eelstretching/led-processor-board/docs/pcb-3d-bottom.png

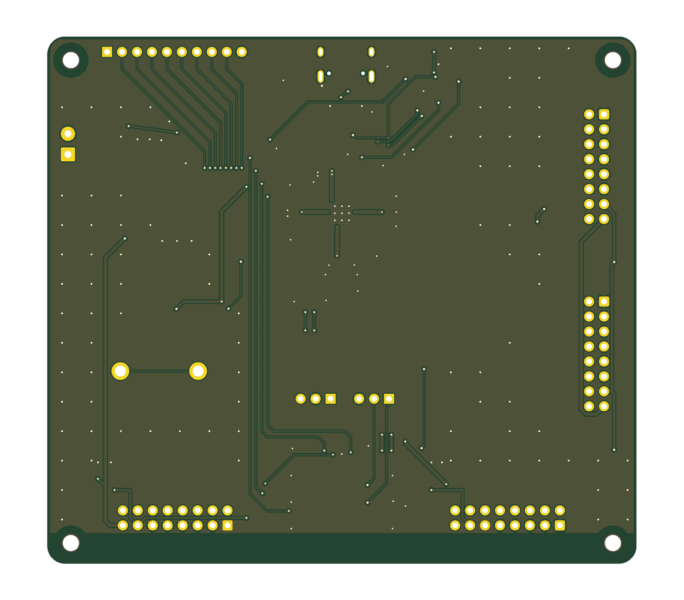
docs/pcb-3d-bottom.png
