eelstretching/led-processor-board/docs/pcb-3d-top.png

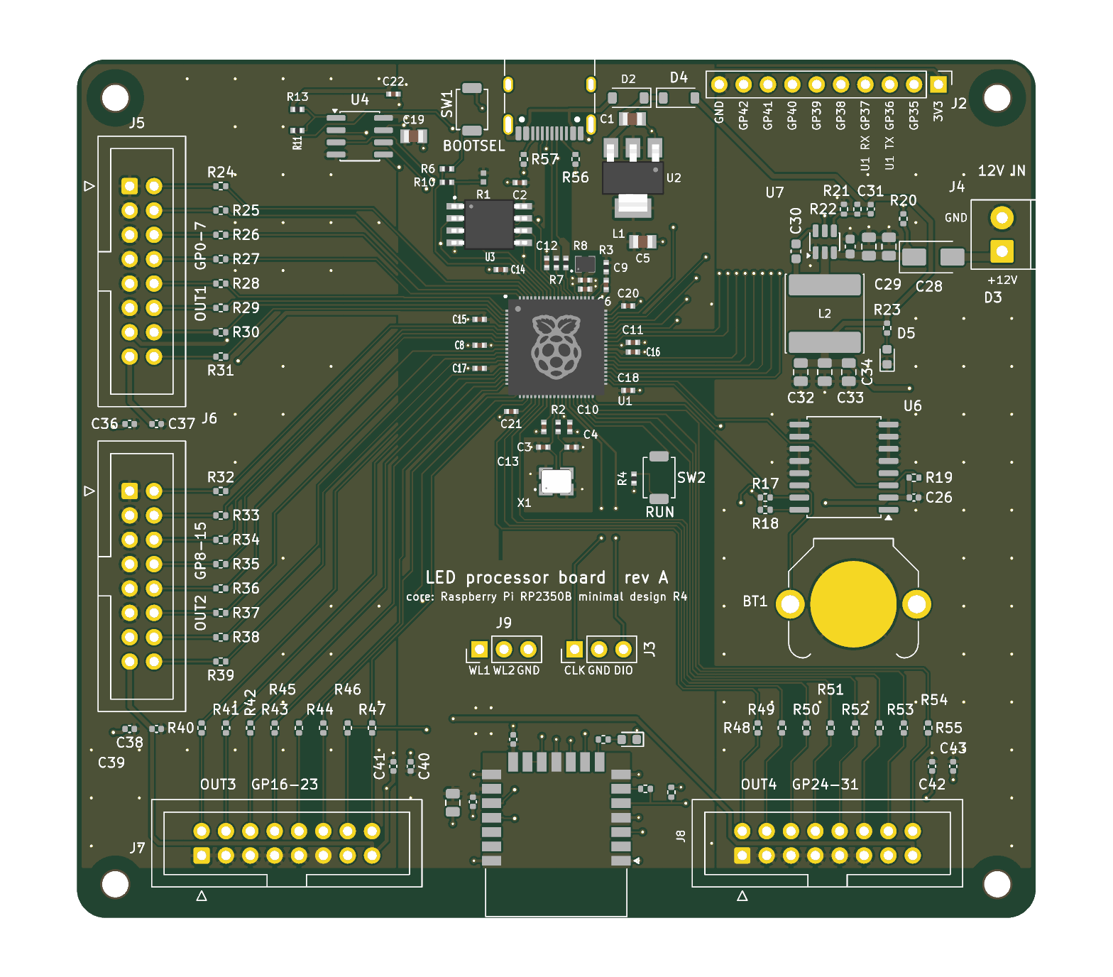
docs/pcb-3d-top.png
