eelstretching/led-processor-board/docs/pcb-bottom-copper.png

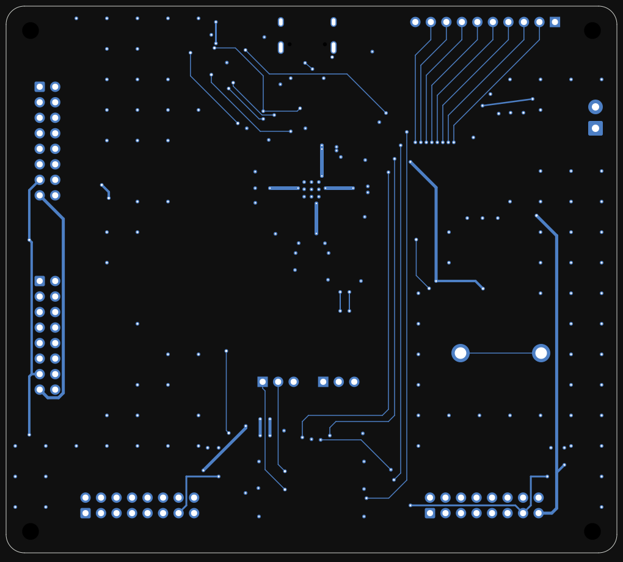
docs/pcb-bottom-copper.png
