eelstretching/led-processor-board/docs/sheet-outputs.png

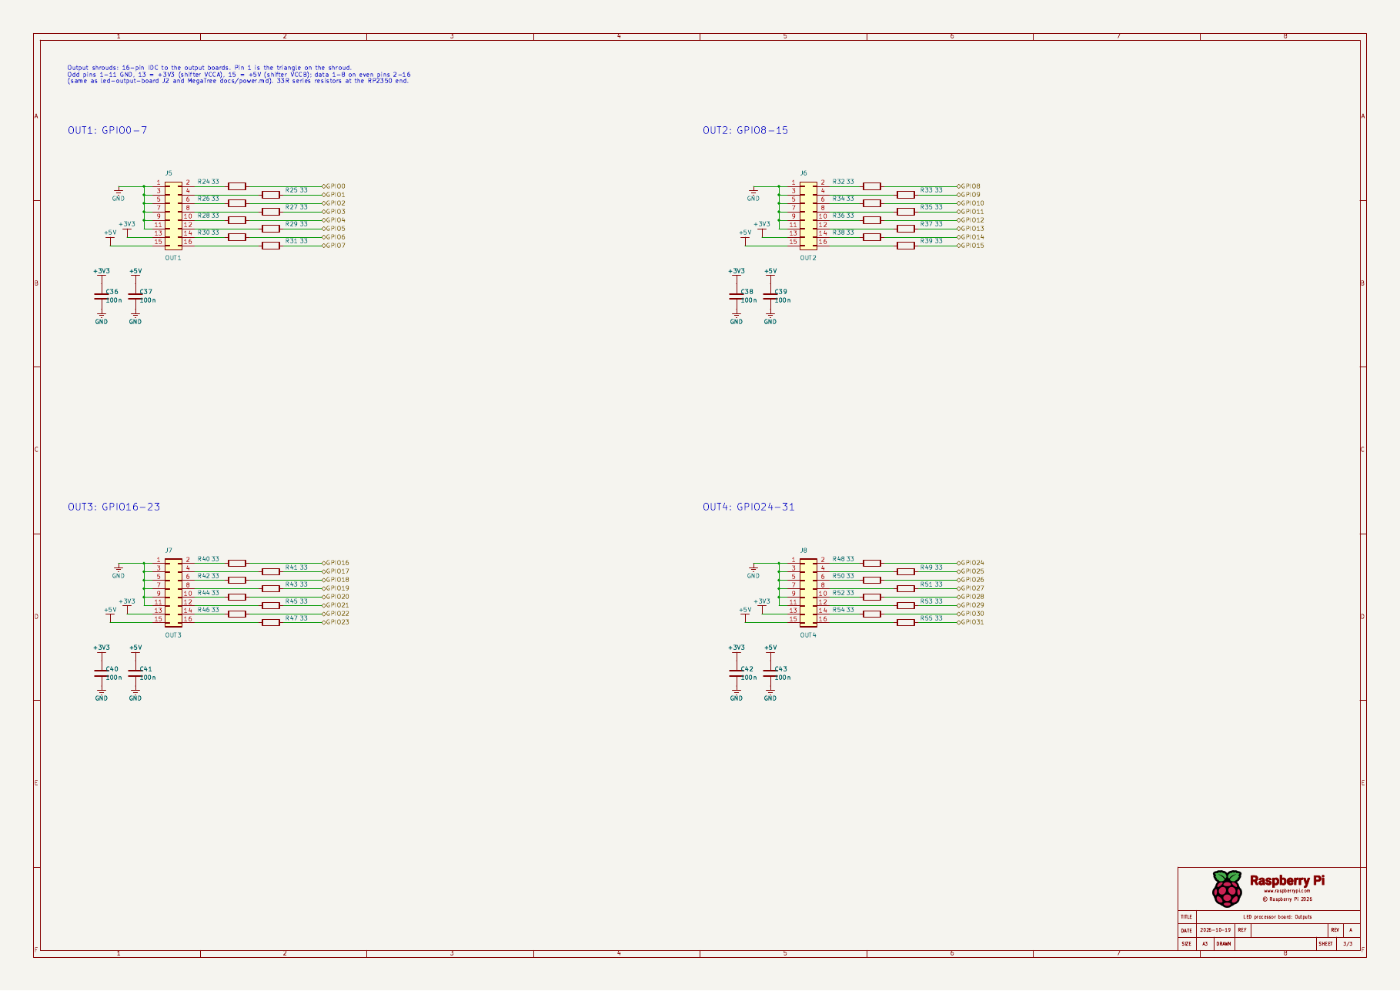
docs/sheet-outputs.png
