eelstretching/led-processor-board/docs/sheet-power.png

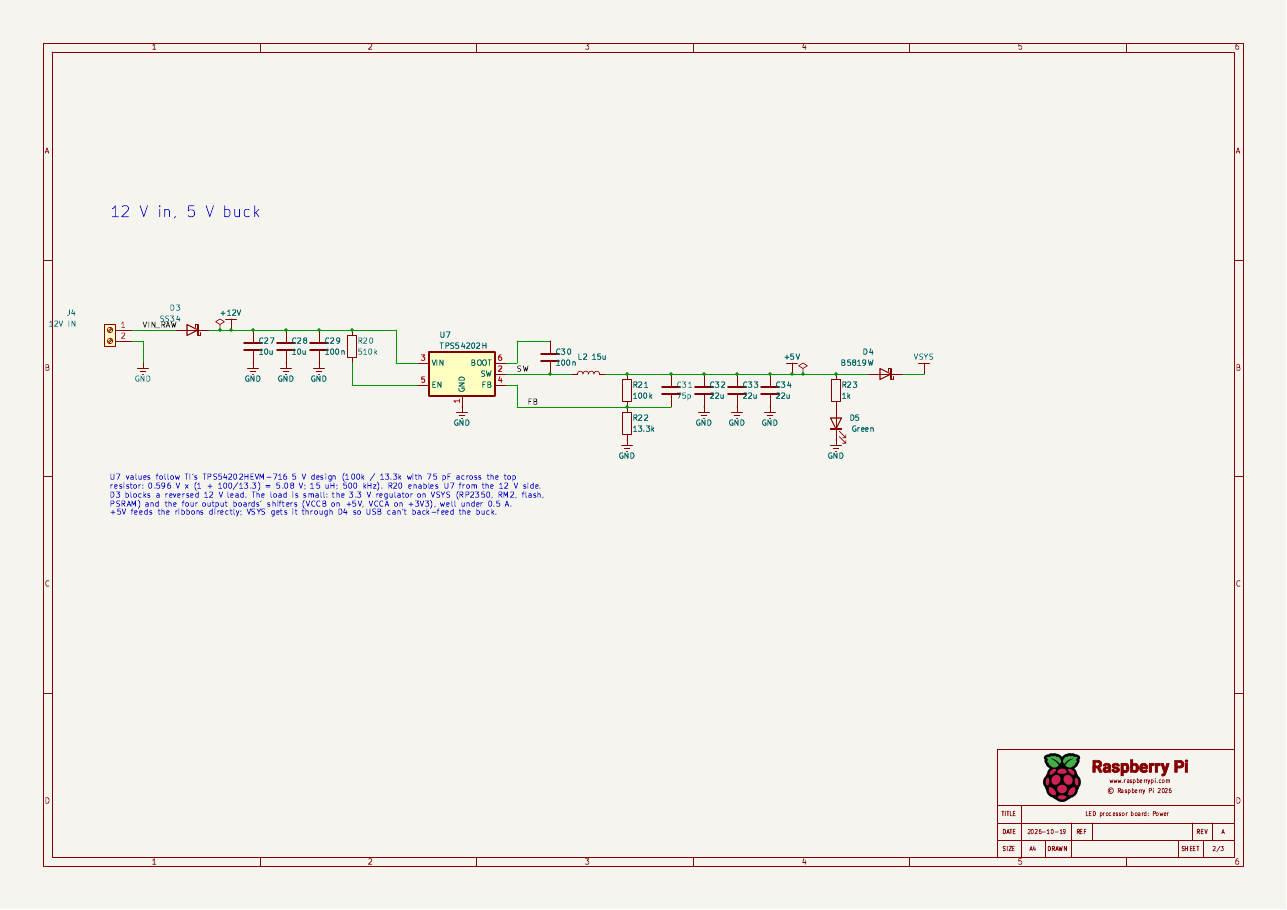
docs/sheet-power.png
