eelstretching/led-processor-board/docs/silk-v1.1/after-full.png

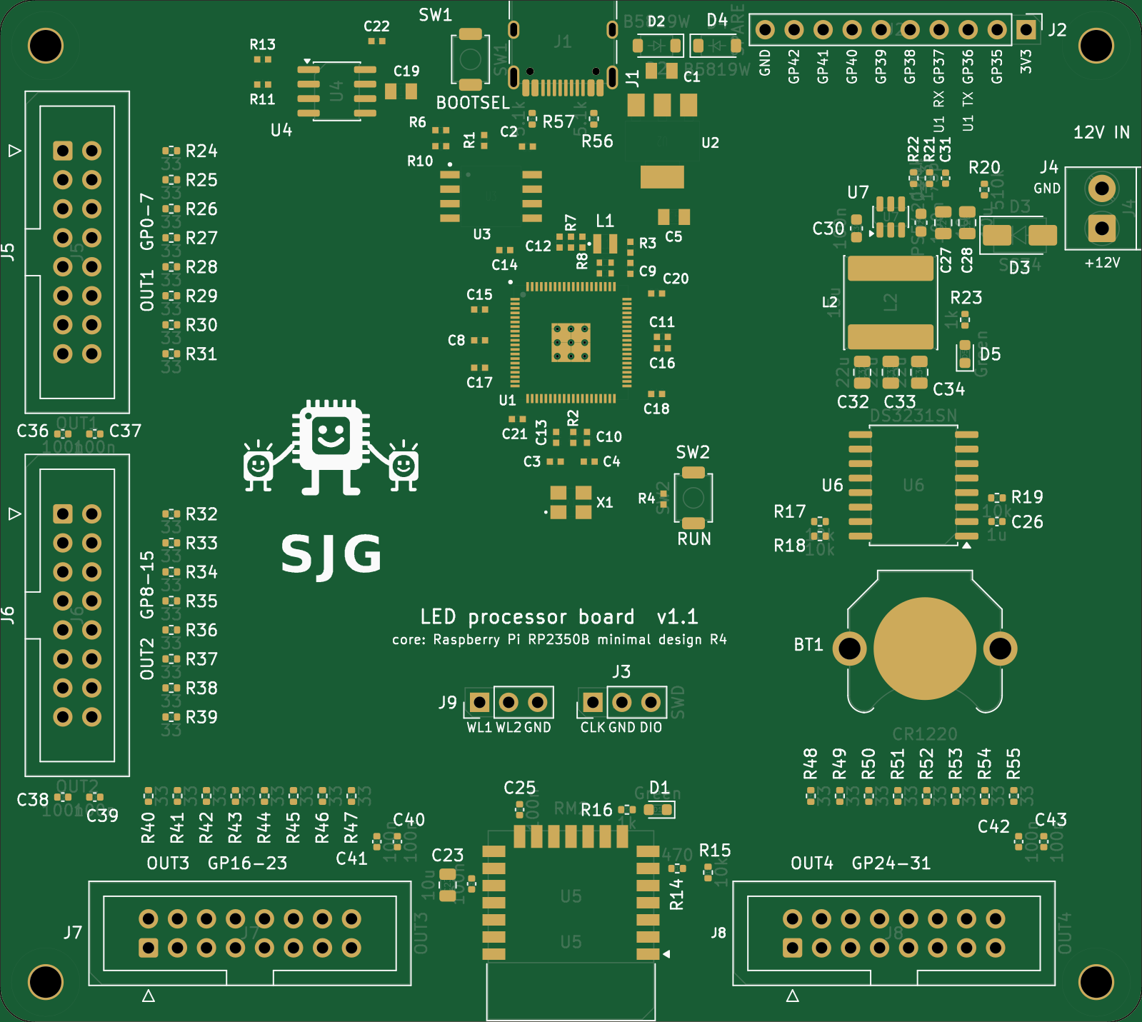
docs/silk-v1.1/after-full.png
