eelstretching/led-processor-board/docs/silk-v1.1/before-full.png

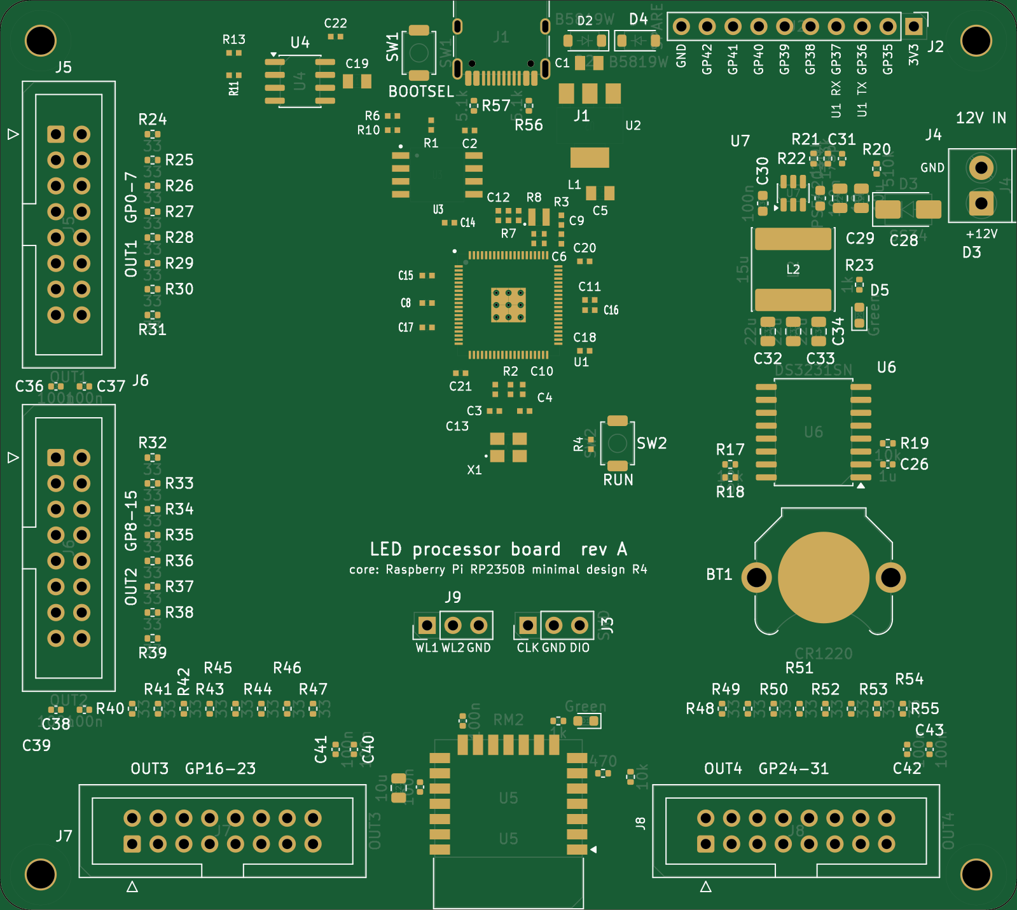
docs/silk-v1.1/before-full.png
