eelstretching/led-processor-board/docs/silk-v1.1/buck-before-after.png

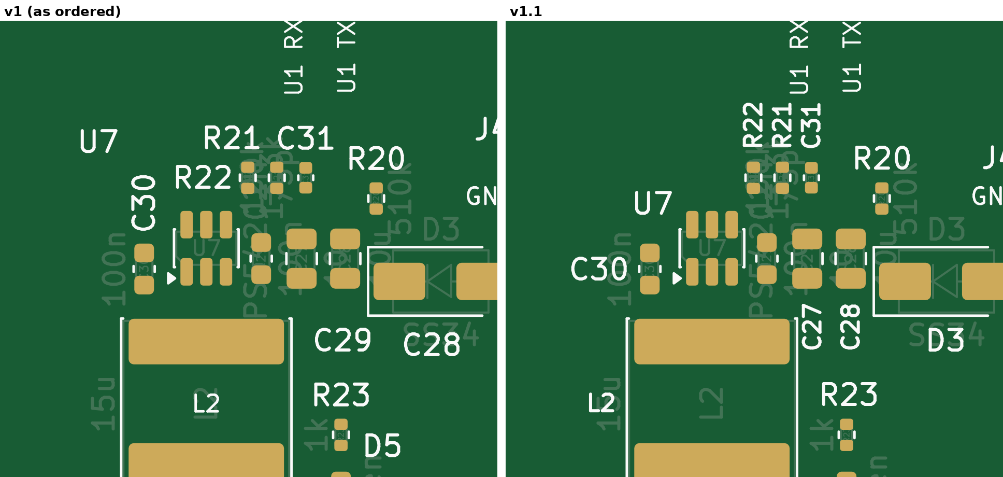
docs/silk-v1.1/buck-before-after.png
