eelstretching/led-processor-board/docs/silk-v1.1/l1-before-after.png

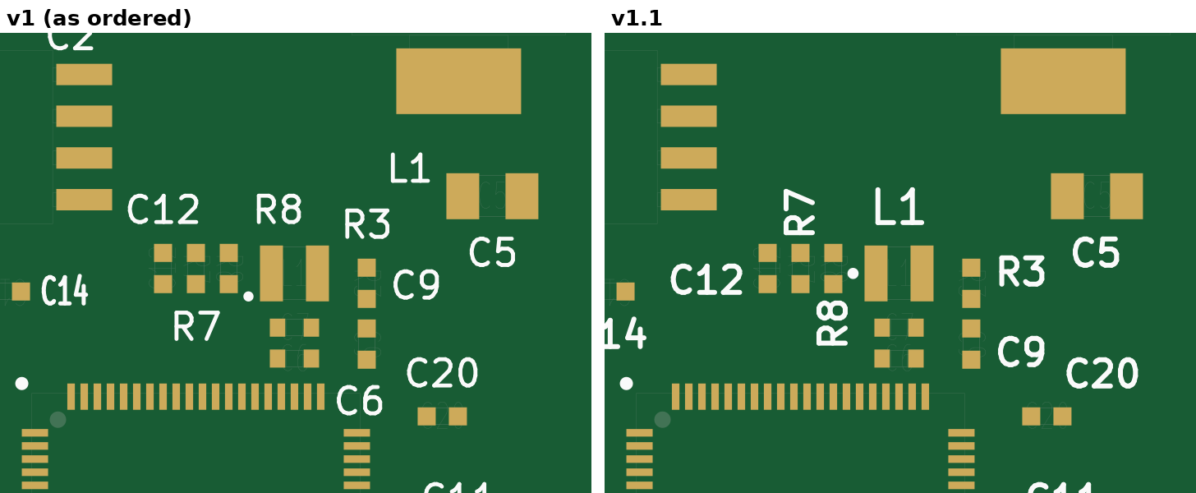
docs/silk-v1.1/l1-before-after.png
