eelstretching/led-processor-board/production/bom-full.csv

Comment | Designator | Footprint | LCSC | Manufacturer PN | Qty | Note
CR1220 | BT1 | BatteryHolder_Keystone_3001_1x12mm |  | 3001 | 1 | Not at LCSC: Keystone 3001 (Digi-Key 36-3001-ND), hand-solder
10u | C1,C5,C19 | generic_capc2012x125 | C15850 | CL21A106KAYNNNE | 3
100n | C2,C8,C10,C11,C12,C13,C14,C15,C16,C17,C18,C20,C21,C22 | generic_capc1005x50 | C1525 | CL05B104KO5NNNC | 14
15p | C3,C4 | generic_capc1005x50 | C1548 | 0402CG150J500NT | 2
4.7u | C6,C7 | generic_capc1005x50_wide | C23733 | CL05A475MP5NRNC | 2
4.7u | C9 | generic_capc1005x50 | C23733 | CL05A475MP5NRNC | 1
10u | C23 | C_0805_2012Metric | C15850 | CL21A106KAYNNNE | 1
100n | C24,C25,C36,C37,C38,C39,C40,C41,C42,C43 | C_0402_1005Metric | C1525 | CL05B104KO5NNNC | 10
1u | C26 | C_0402_1005Metric | C52923 | CL05A105KA5NQNC | 1
10u | C27,C28 | C_0805_2012Metric | C440198 | CL21A106KBYNNNE | 2
100n | C29,C30 | C_0603_1608Metric | C14663 | CC0603KRX7R9BB104 | 2
75p | C31 | C_0402_1005Metric | C37809 | 0402CG750J500NT | 1
22u | C32,C33,C34 | C_0805_2012Metric | C45783 | CL21A226MAQNNNE | 3
Green | D1,D5 | LED_0603_1608Metric | C2289 | KT-0603YG | 2
B5819W | D2,D4 | D_SOD-123 | C8598 | B5819W SL | 2
SS34 | D3 | D_SMA | C8678 | SS34 | 1
USB-C | J1 | USB_C_Receptacle_HRO_TYPE-C-31-M-12 | C165948 | TYPE-C-31-M-12 | 1
SPARE | J2 | PinHeader_1x10_P2.54mm_Vertical |  | 1x10 2.54 mm pin header | 1 | Through-hole: hand-solder
SWD | J3 | PinHeader_1x03_P2.54mm_Vertical |  | 1x3 2.54 mm pin header | 1 | Through-hole: hand-solder
12V IN | J4 | TerminalBlock_Phoenix_PT-1,5-2-3.5-H_1x02_P3.50mm_Horizontal | C695629 | DB301V-3.5-2P-GN-S | 1 | Through-hole
OUT1 | J5 | IDC-Header_2x08_P2.54mm_Vertical |  | Box header 2x08 2.54 mm | 1 | Through-hole: hand-solder (same shroud as the output boards)
OUT2 | J6 | IDC-Header_2x08_P2.54mm_Vertical |  | Box header 2x08 2.54 mm | 1 | Through-hole: hand-solder (same shroud as the output boards)
OUT3 | J7 | IDC-Header_2x08_P2.54mm_Vertical |  | Box header 2x08 2.54 mm | 1 | Through-hole: hand-solder (same shroud as the output boards)
OUT4 | J8 | IDC-Header_2x08_P2.54mm_Vertical |  | Box header 2x08 2.54 mm | 1 | Through-hole: hand-solder (same shroud as the output boards)
WL_GPIO | J9 | PinHeader_1x03_P2.54mm_Vertical |  | 1x3 2.54 mm pin header | 1 | Through-hole: hand-solder
3.3u | L1 | abracon_aota-b201610s3r3-101-t | C42411119 | AOTA-B201610S3R3-101-T | 1
15u | L2 | L_Sunlord_SWPA8040S | C16853 | SWPA8040S150MT | 1
1k | R2,R4,R6 | generic_resc1005x35 | C11702 | 0402WGF1001TCE | 3
33 | R3 | generic_resc1005x35 | C25105 | 0402WGF330JTCE | 1
27 | R7,R8 | generic_resc1005x35 | C25100 | 0402WGF270JTCE | 2
0 | R10,R11 | generic_resc1005x35 | C17168 | 0402WGF0000TCE | 2
10k | R13 | generic_resc1005x35 | C25744 | 0402WGF1002TCE | 1
470 | R14 | R_0402_1005Metric | C25117 | 0402WGF4700TCE | 1
10k | R15,R17,R18,R19 | R_0402_1005Metric | C25744 | 0402WGF1002TCE | 4
1k | R16,R23 | R_0402_1005Metric | C11702 | 0402WGF1001TCE | 2
510k | R20 | R_0402_1005Metric | C11616 | 0402WGF5103TCE | 1
100k | R21 | R_0402_1005Metric | C25741 | 0402WGF1003TCE | 1
13.3k | R22 | R_0402_1005Metric | C122547 | 0402WGF1332TCE | 1
33 | R24,R25,R26,R27,R28,R29,R30,R31,R32,R33,R34,R35,R36,R37,R38,R39,R40,R41,R42,R43,R44,R45,R46,R47,R48,R49,R50,R51,R52,R53,R54,R55 | R_0402_1005Metric | C25105 | 0402WGF330JTCE | 32
5.1k | R56,R57 | R_0402_1005Metric | C25905 | 0402WGF5101TCE | 2
TS-1088R-02526 | SW1,SW2 | SW_SPST_TS-1088-xR025 | C455281 | TS-1088R-02526 | 2
RP2350B | U1 | rpi_rp2350b_vias | C42415655 | RP2350B | 1
NCP1117ST33T3G | U2 | onsemi_ncp1117st33t3g | C26537 | NCP1117ST33T3G | 1
W25Q128JVSIQ | U3 | generic_soic127p790x195-8 | C97521 | W25Q128JVSIQ | 1
APS6404L-3SQR-SN | U4 | SOIC-8_3.9x4.9mm_P1.27mm | C5333729 | APS6404L-3SQR-SN | 1
RM2 | U5 | RPi_RM2 |  | SC1169 (RMC20452T) | 1 | Not at LCSC: buy RM2 (Raspberry Pi SC1169) and hand-solder
DS3231SN | U6 | SOIC-16W_7.5x10.3mm_P1.27mm | C9866 | DS3231SN#T&R | 1
TPS54202H | U7 | SOT-23-6 | C527684 | TPS54202HDDCR | 1
12MHz | X1 | generic_xtalcc320x250x80-4 | C20625731 | ABM8-272-T3 | 1
