eelstretching/led-processor-board/docs/schematic.pdf

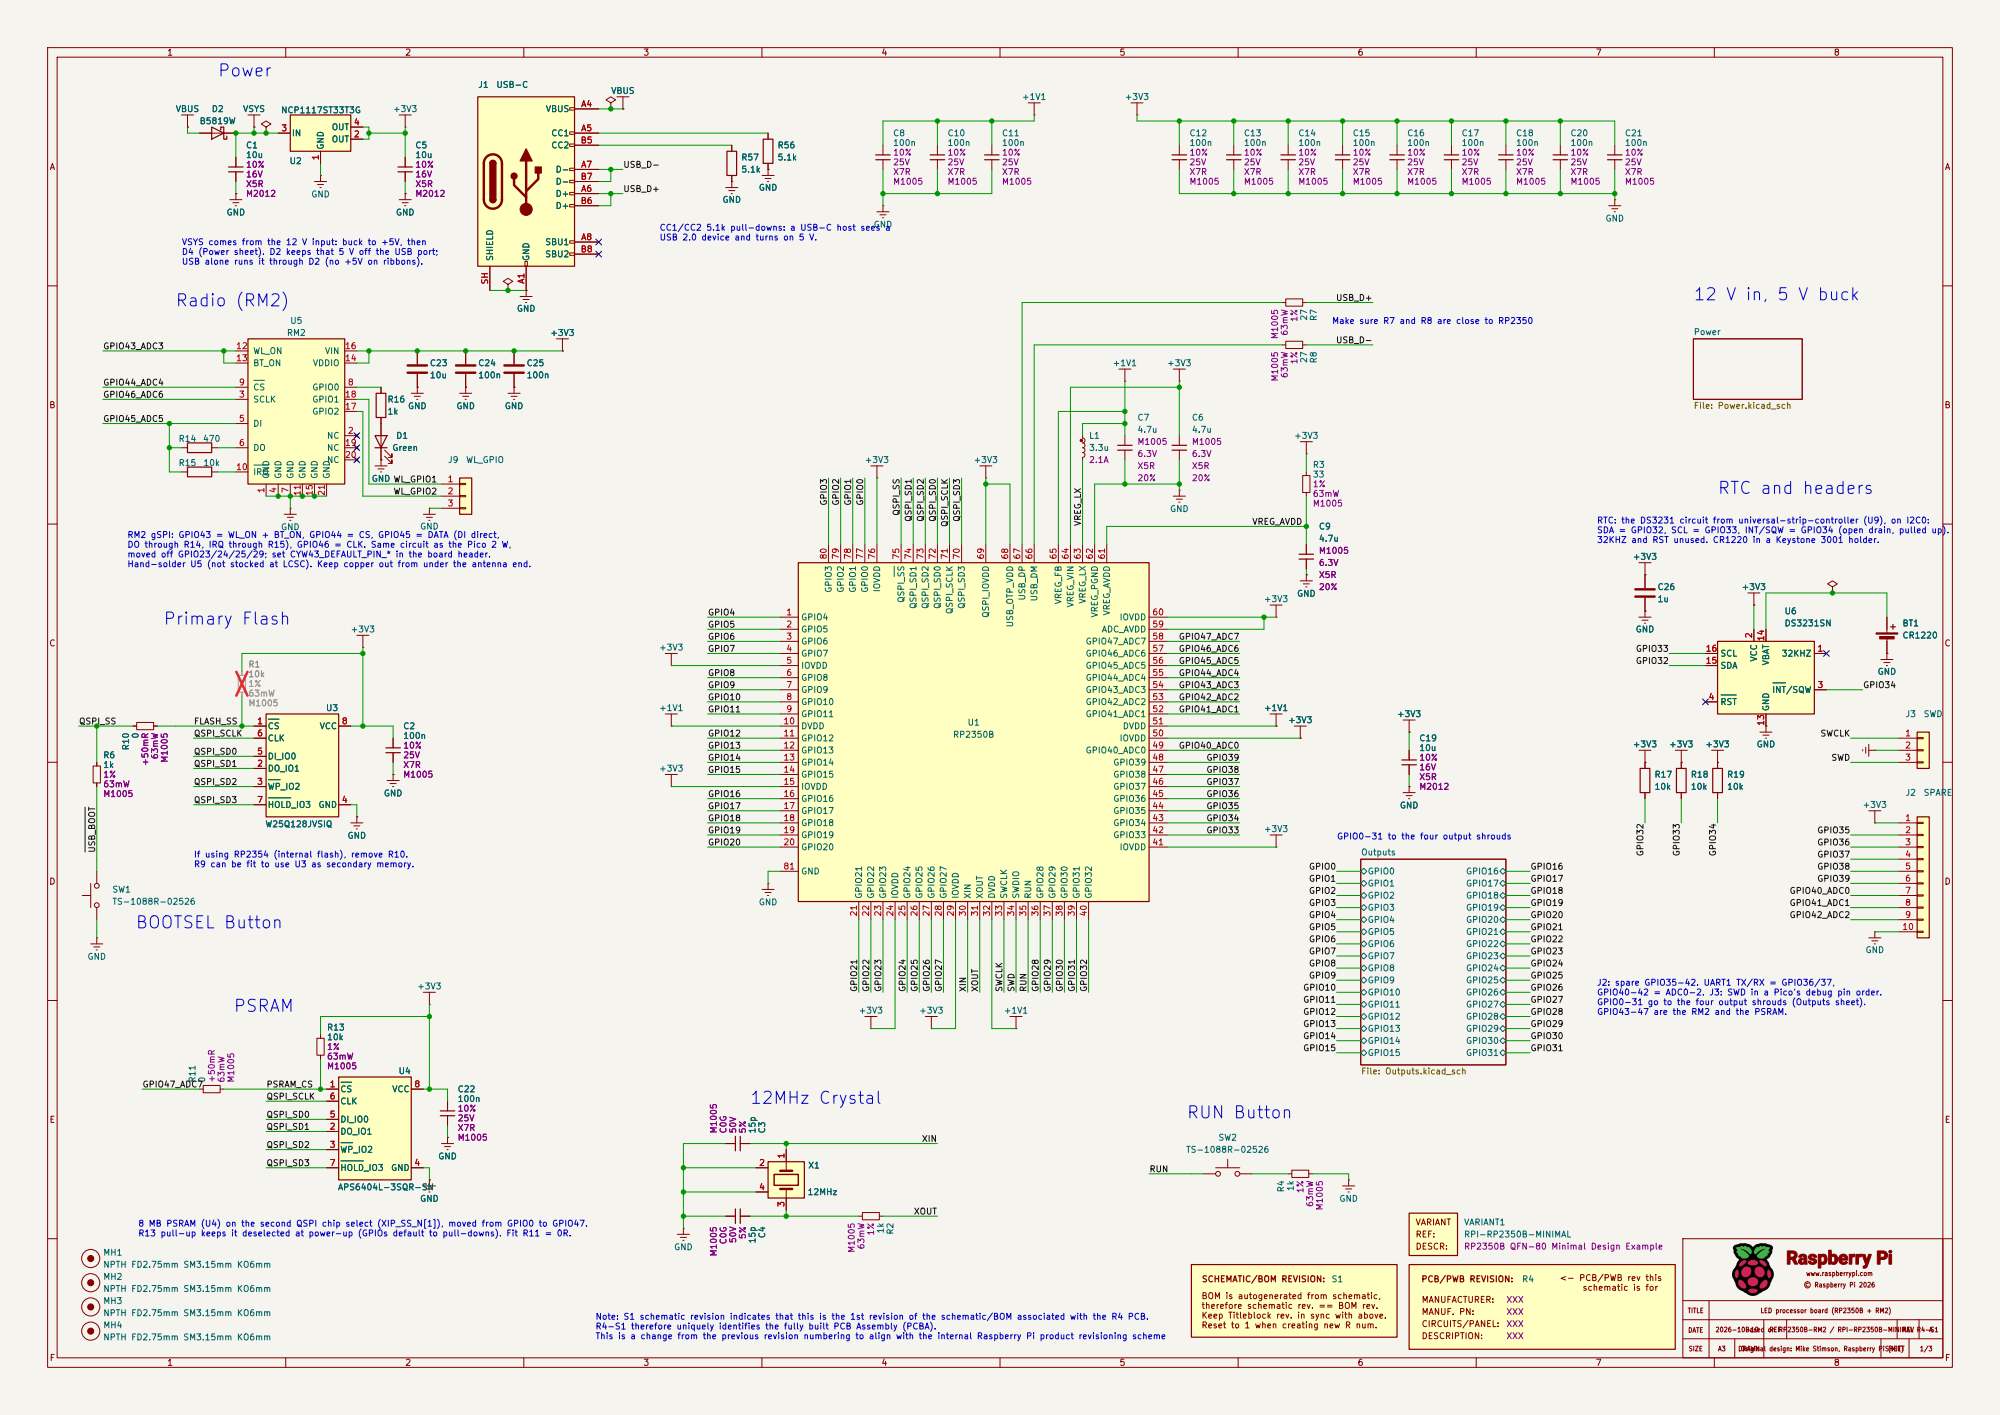
[picture p12: page 1]

VSYS comes from the 12 V input: buck to +5V, then D4 (Power sheet). D2 keeps that 5 V off the USB port; USB alone runs it through D2 (no +5V on ribbons).

RTC: the DS3231 circuit from universal-strip-controller (U9), on I2C0: SDA = GPIO32, SCL = GPIO33, INT/SQW = GPIO34 (open drain, pulled up). 32KHZ and RST unused. CR1220 in a Keystone 3001 holder. 12 V in, 5 V buck

Make sure R7 and R8 are close to RP2350

GPIO0-31 to the four output shrouds GND

J2: spare GPIO35-42. UART1 TX/RX = GPIO36/37, GPIO40-42 = ADC0-2. J3: SWD in a Pico's debug pin order. GPIO0-31 go to the four output shrouds (Outputs sheet). GPIO43-47 are the RM2 and the PSRAM.

TITLE | DRAWN LED processor board (RP2350B + RM2) DATE 2026-10-19

Note: S1 schematic revision indicates that this is the 1st revision of the schematic/BOM associated with the R4 PCB. R4-S1 therefore uniquely identifies the fully built PCB Assembly (PCBA). This is a change from the previous revision numbering to align with the internal Raspberry Pi product revisioning scheme

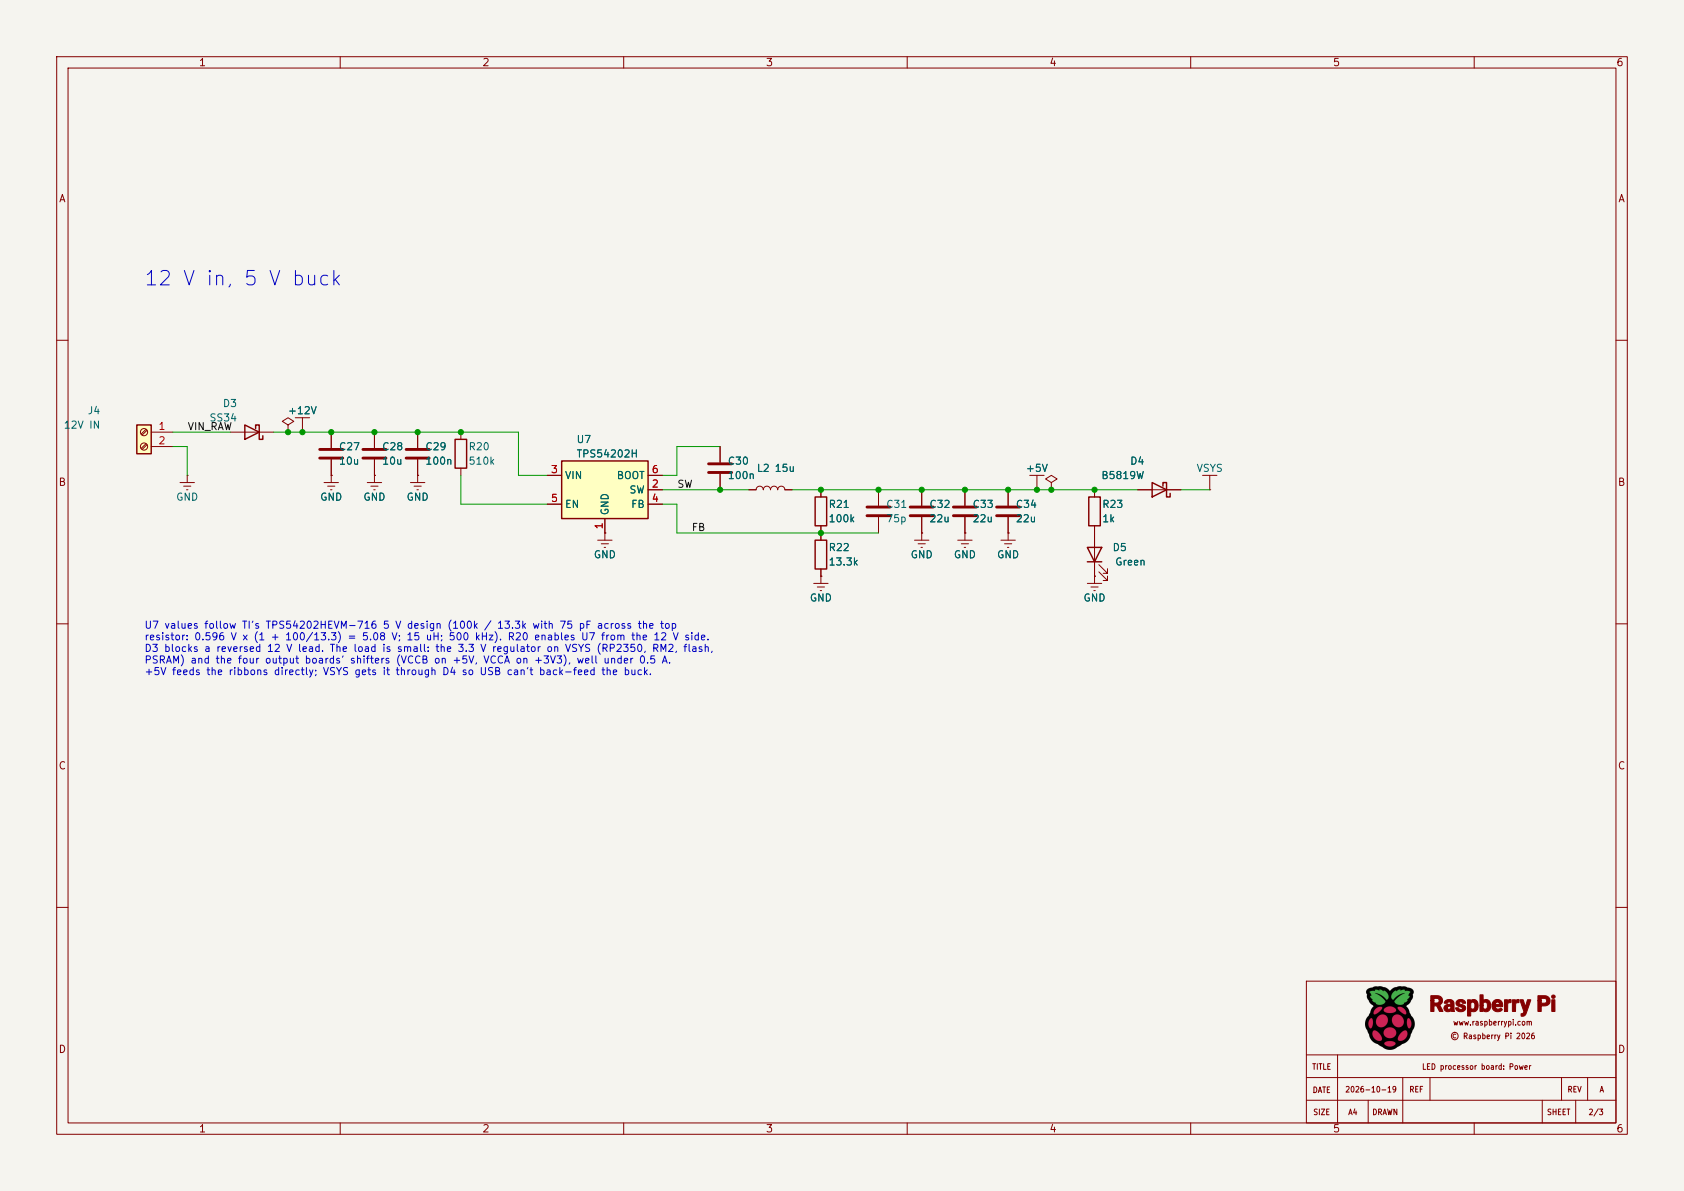
[picture p13: page 2]

PSRAM) and the four output boards' shifters (VCCB on +5V, VCCA on +3V3), well under 0.5 A. +5V feeds the ribbons directly; VSYS gets it through D4 so USB can't back-feed the buck. 12 V in, 5 V buck

U7 values follow TI's TPS54202HEVM-716 5 V design (100k / 13.3k with 75 pF across the top
resistor: 0.596 V x (1 + 100/13.3) = 5.08 V; 15 uH; 500 kHz). R20 enables U7 from the 12 V side. D3 blocks a reversed 12 V lead. The load is small: the 3.3 V regulator on VSYS (RP2350, RM2, flash,

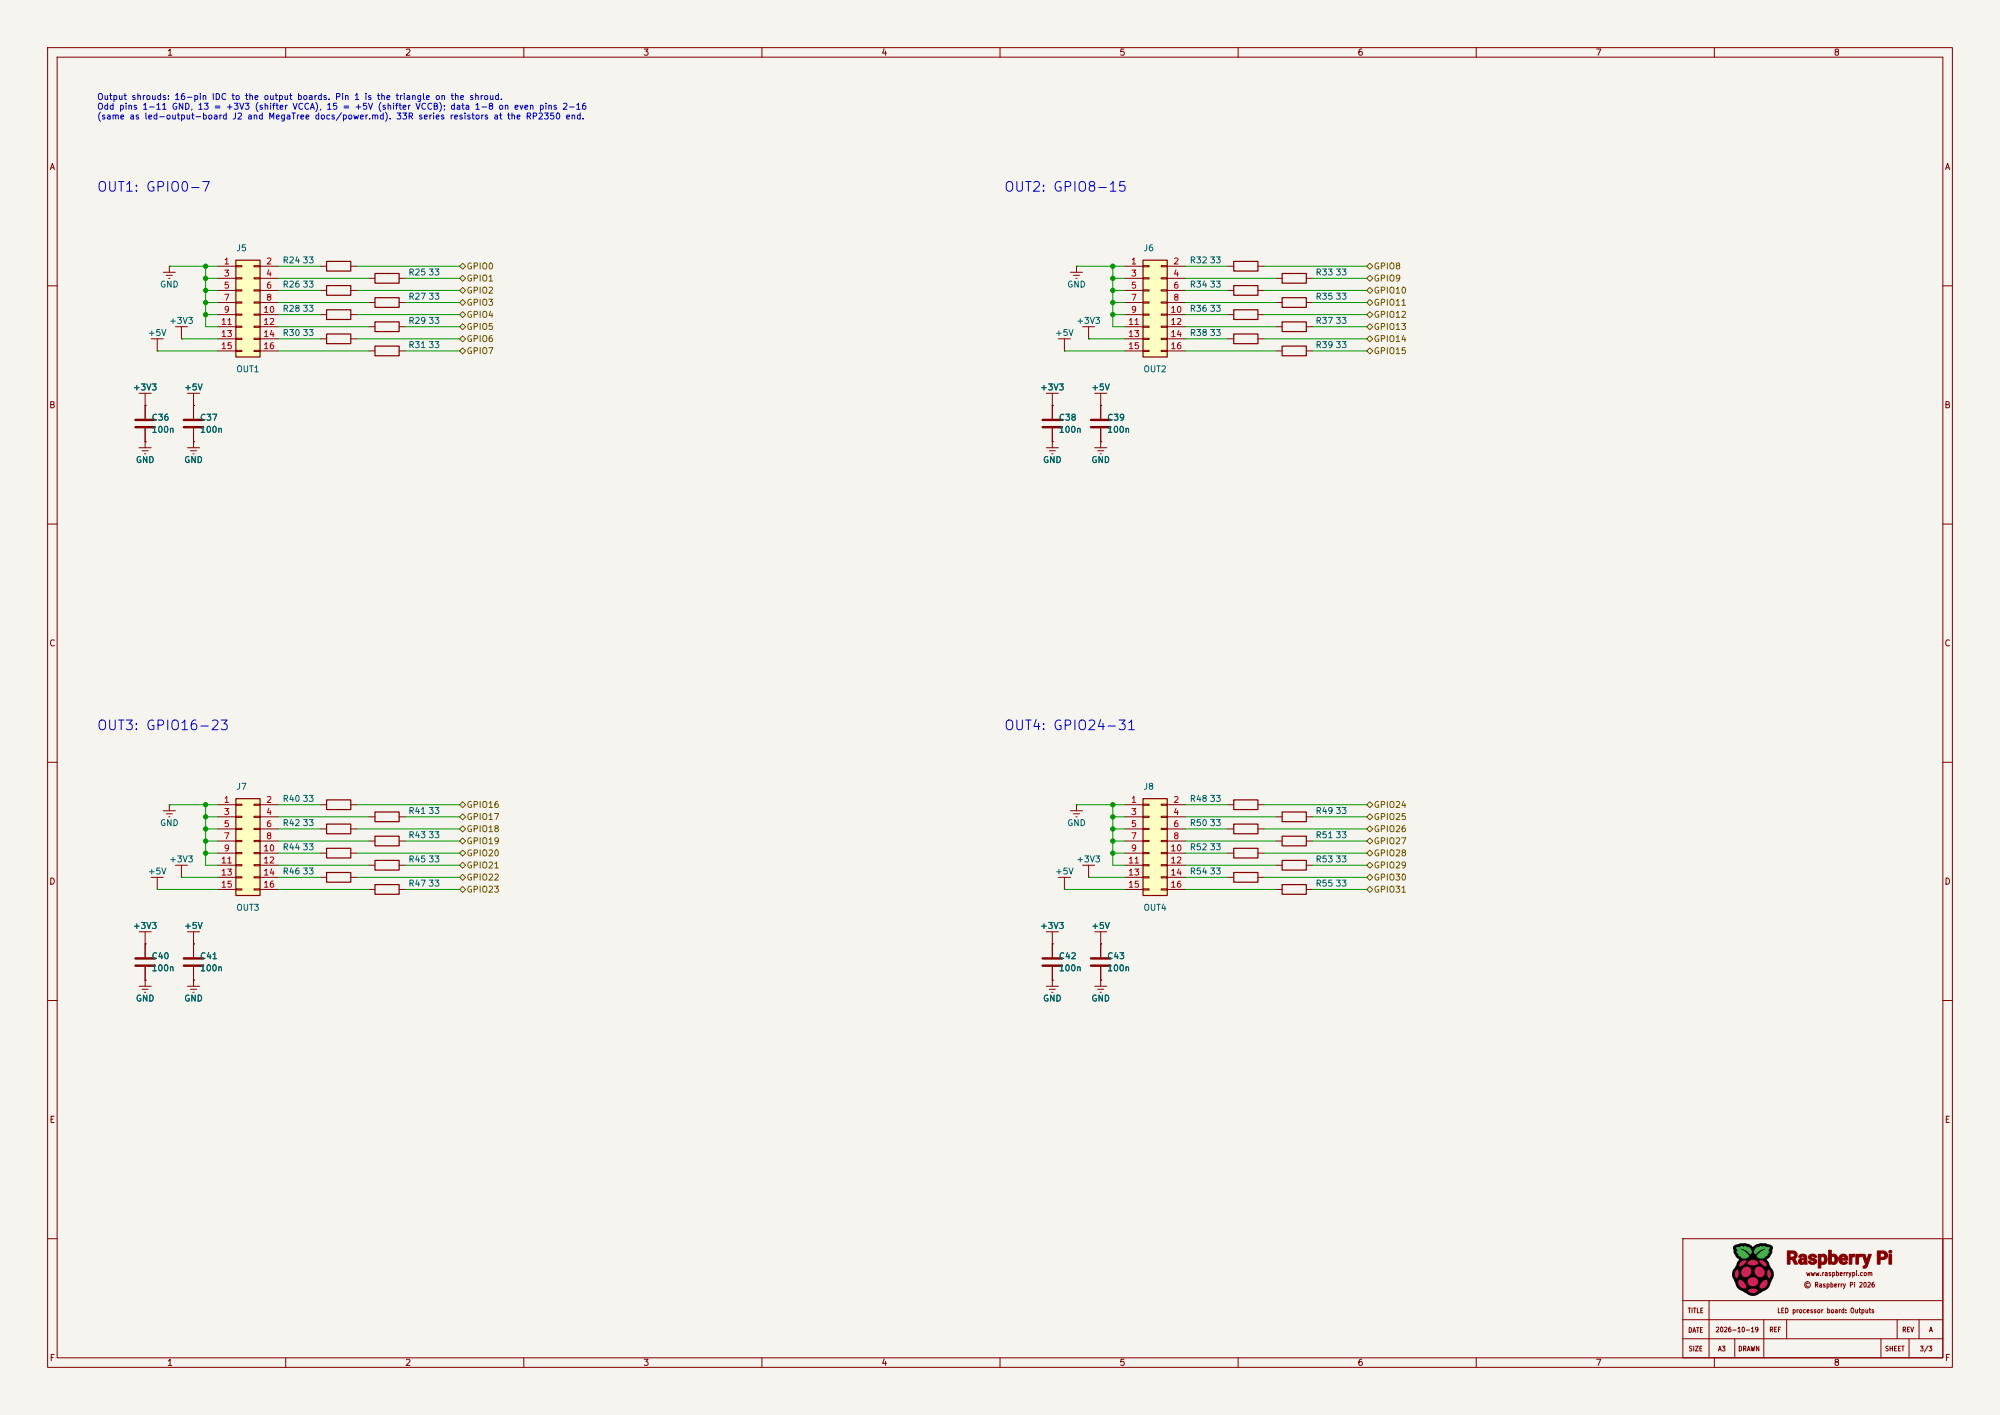
[picture p14: page 3]

Output shrouds: 16-pin IDC to the output boards. Pin 1 is the triangle on the shroud. Odd pins 1-11 GND, 13 = +3V3 (shifter VCCA), 15 = +5V (shifter VCCB); data 1-8 on even pins 2-16

(same as led-output-board J2 and MegaTree docs/power.md). 33R series resistors at the RP2350 end. OUT3: GPIO16-23
