eelstretching/led-processor-board/led-processor-board.kicad_pcb

## KiCad design led-processor-board.kicad_pcb (2026-10-31)

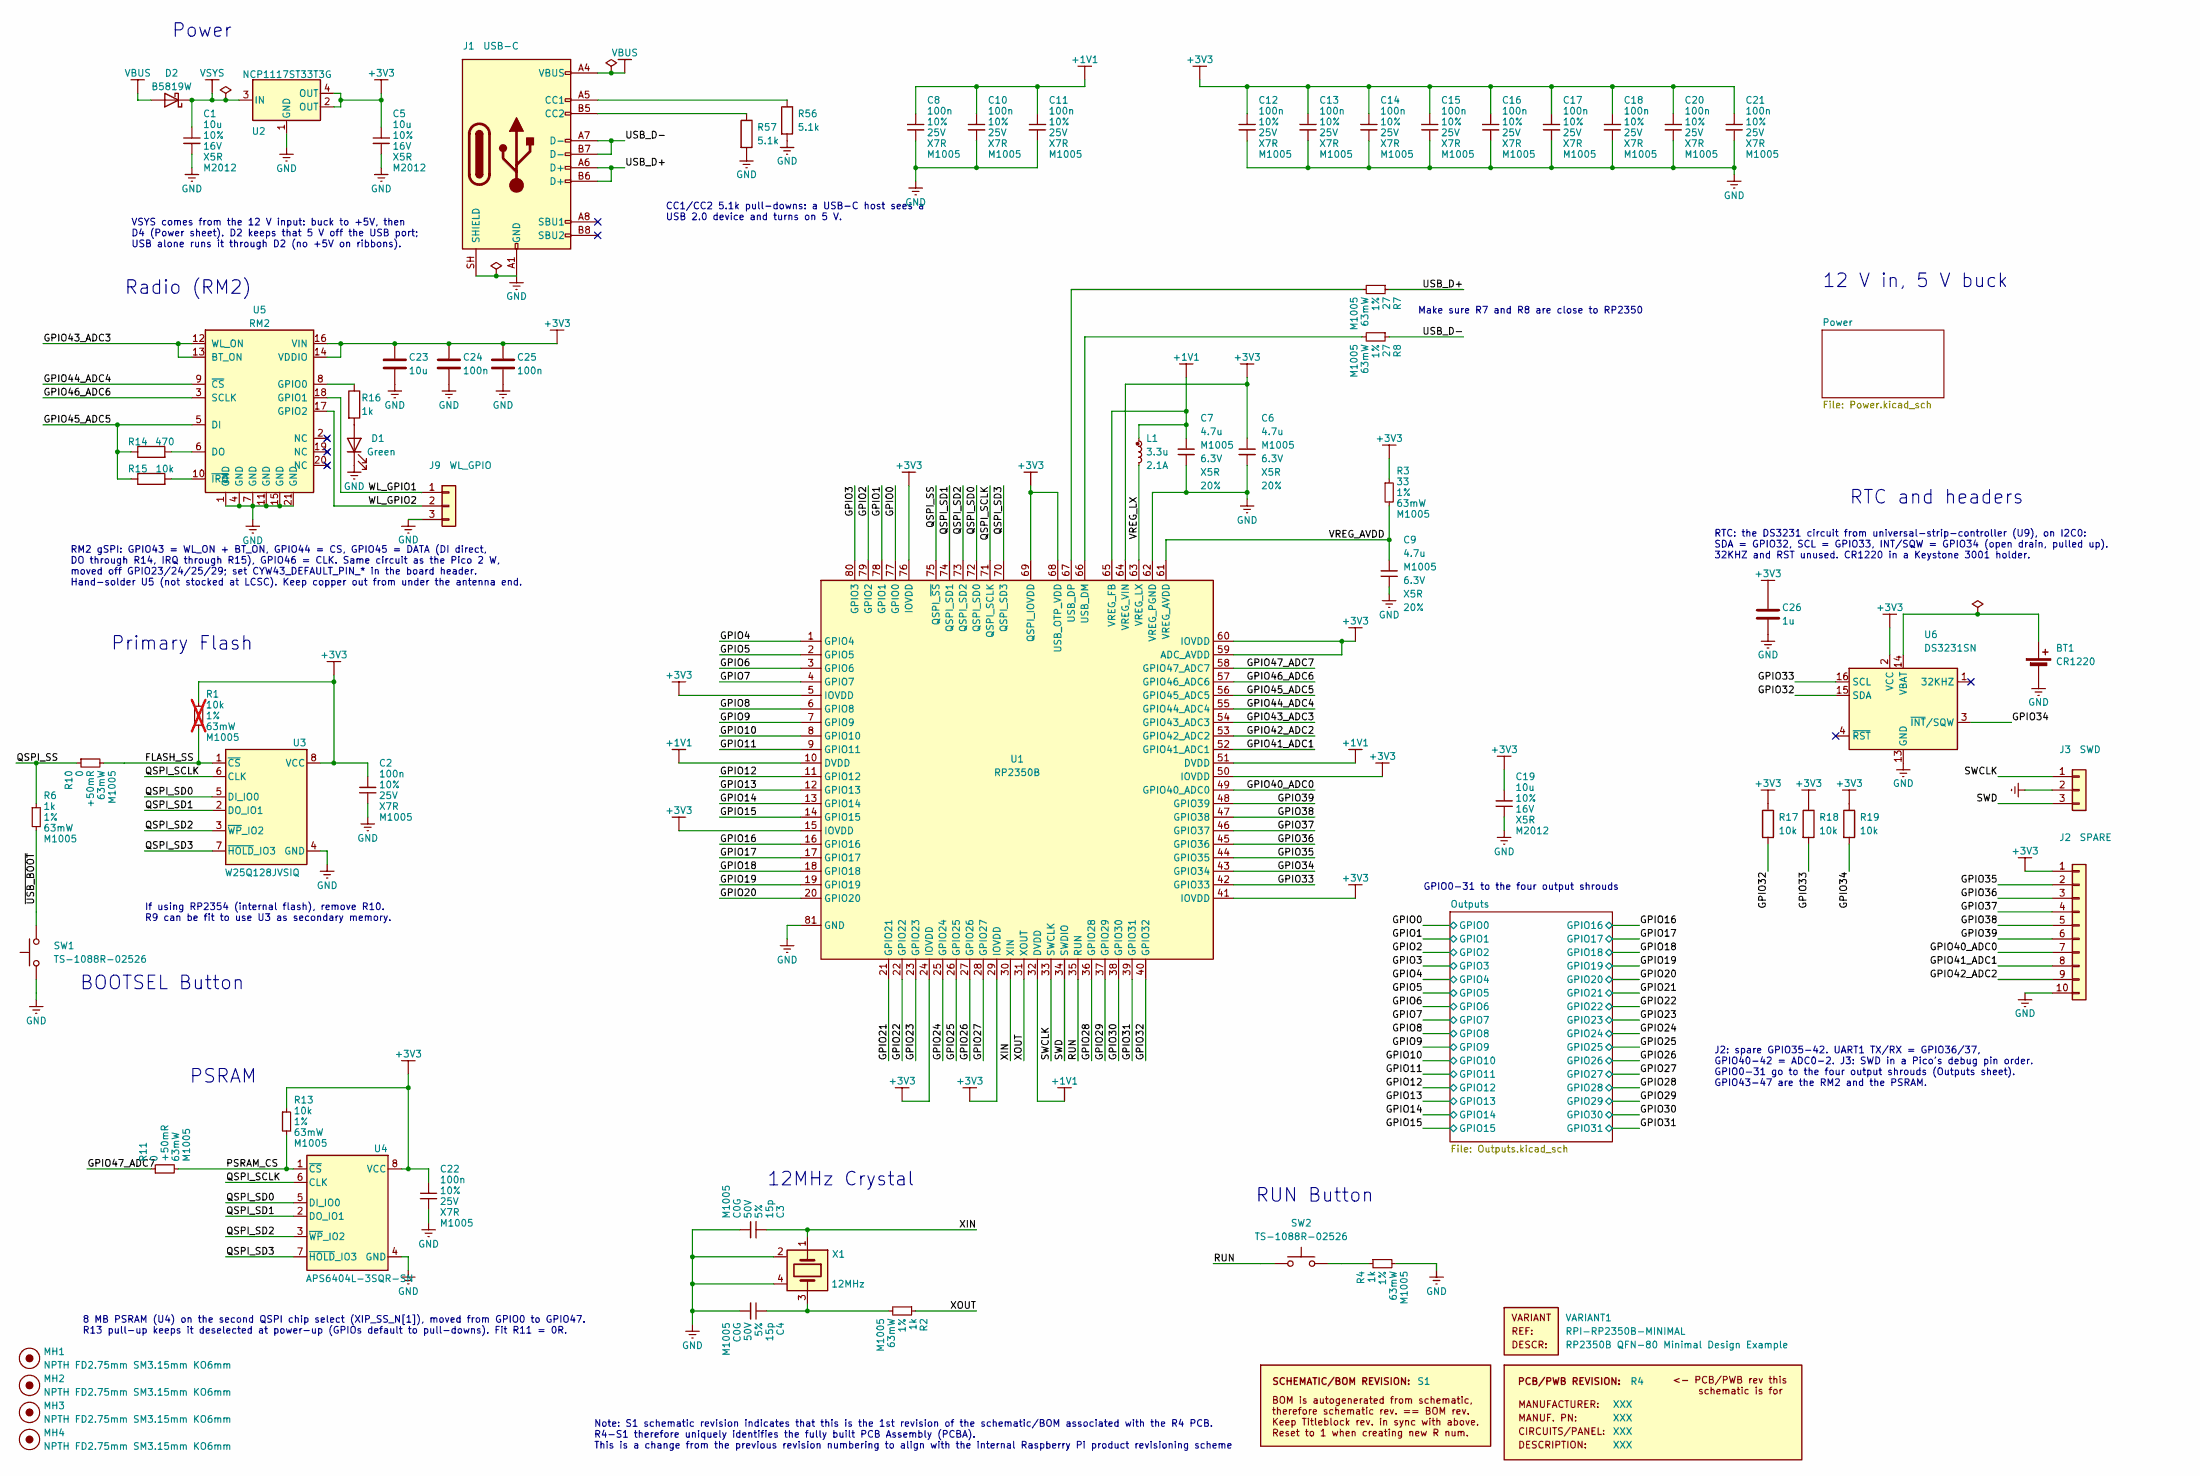
[picture p15: schematic led-processor-board.kicad_sch, LED processor board (RP2350B + RM2)]

Parts:
BT1: CR1220; BatteryHolder_Keystone_3001_1x12mm; manufacturer_pn 3001
C1, C5, C19: 10u; generic_capc2012x125; voltage 16V; tolerance 10%; part_uid RP-01GYSK-AVBE41; LCSC C15850
C2, C8, C10, C11, C12, C13, C14, C15, C16, C17, C18, C20, C21, C22: 100n; generic_capc1005x50; voltage 25V; tolerance 10%; part_uid RP-01BJ9Y-KRGF41; LCSC C1525
C3, C4: 15p; generic_capc1005x50; voltage 50V; tolerance 5%; part_uid RP-01C89W-LLY9XV; LCSC C1548
C6, C7: 4.7u; generic_capc1005x50_wide; voltage 6.3V; tolerance 20%; part_uid RP-019A1P-0C2GHY; LCSC C23733
C9: 4.7u; generic_capc1005x50; voltage 6.3V; tolerance 20%; part_uid RP-019A1P-0C2GHY; LCSC C23733
C23: 10u; C_0805_2012Metric; manufacturer_pn CL21A106KAYNNNE; LCSC C15850
C24, C25: 100n; C_0402_1005Metric; manufacturer_pn CL05B104KO5NNNC; LCSC C1525
C26: 1u; C_0402_1005Metric; manufacturer_pn CL05A105KA5NQNC; LCSC C52923
D1: Green; LED_0603_1608Metric; manufacturer_pn KT-0603YG; LCSC C2289
D2: B5819W; D_SOD-123; manufacturer_pn B5819W SL; LCSC C8598
J1: USB-C; USB_C_Receptacle_HRO_TYPE-C-31-M-12; manufacturer_pn TYPE-C-31-M-12; LCSC C165948
J2: SPARE; PinHeader_1x10_P2.54mm_Vertical; manufacturer_pn 1x10 2.54 mm pin header
J3: SWD; PinHeader_1x03_P2.54mm_Vertical; manufacturer_pn 1x3 2.54 mm pin header
J9: WL_GPIO; PinHeader_1x03_P2.54mm_Vertical; manufacturer_pn 1x3 2.54 mm pin header
L1: 3.3u; abracon_aota-b201610s3r3-101-t; tolerance 20%; part_uid RP-01GY5D-2VC7WP; LCSC C42411119
MH1, MH2, MH3, MH4: NPTH FD2.75mm SM3.15mm KO6mm; none_mh_npth_fd2p75mm_sm3p15mm_ko6mm; part_uid RP-01HF5R-LCTEJS
PCB1: R4; manufacturer_pn XXX
R1: 10k; generic_resc1005x35; tolerance 1%; voltage 50V; part_uid RP-019A1P-53DHSX; LCSC C25744; not fitted
R2, R4, R6: 1k; generic_resc1005x35; tolerance 1%; voltage 50V; part_uid RP-019A1P-4Z6ZWY; LCSC C11702
R3: 33; generic_resc1005x35; tolerance 1%; voltage 50V; part_uid RP-019A1P-58PW9L; LCSC C25105
R7, R8: 27; generic_resc1005x35; tolerance 1%; voltage 50V; part_uid RP-01C89V-LTEYC4; LCSC C25100
R10, R11: 0; generic_resc1005x35; tolerance +50mR; voltage 50V; part_uid RP-019A1P-4Y4V63; LCSC C17168
R13: 10k; generic_resc1005x35; tolerance 1%; voltage 50V; part_uid RP-019A1P-53DHSX; LCSC C25744
R14: 470; R_0402_1005Metric; manufacturer_pn 0402WGF4700TCE; LCSC C25117
R15, R17, R18, R19: 10k; R_0402_1005Metric; manufacturer_pn 0402WGF1002TCE; LCSC C25744
R16: 1k; R_0402_1005Metric; manufacturer_pn 0402WGF1001TCE; LCSC C11702
R56, R57: 5.1k; R_0402_1005Metric; manufacturer_pn 0402WGF5101TCE; LCSC C25905
SBREV1: S1
SW1, SW2: TS-1088R-02526; SW_SPST_TS-1088-xR025; manufacturer_pn TS-1088R-02526; LCSC C455281
U1: RP2350B; rpi_rp2350b_vias; part_uid RP-01HA9H-ABBLJN; LCSC C42415655
U2: NCP1117ST33T3G; onsemi_ncp1117st33t3g; voltage 3.3V; part_uid RP-01JWD9-7JRX6J; LCSC C26537
U3: W25Q128JVSIQ; generic_soic127p790x195-8; voltage 2.7-3.6V; part_uid RP-01JWD4-F1H4N9; LCSC C97521
U4: APS6404L-3SQR-SN; SOIC-8_3.9x4.9mm_P1.27mm; voltage 2.7-3.6V; manufacturer_pn APS6404L-3SQR-SN; LCSC C5333729
U5: RM2; RPi_RM2; manufacturer_pn SC1169 (RMC20452T)
U6: DS3231SN; SOIC-16W_7.5x10.3mm_P1.27mm; manufacturer_pn DS3231SN#T&R; LCSC C9866
VARIANT1: RPI-RP2350B-MINIMAL
X1: 12MHz; generic_xtalcc320x250x80-4; tolerance 30ppm; part_uid RP-01G8X7-GS352B; LCSC C20625731

Connections:
+1V1: C7.1, C8.1, C10.1, C11.1, L1.1, U1.10 (DVDD), U1.32 (DVDD), U1.51 (DVDD), U1.65 (VREG_FB)
+3V3: C2.1, C5.1, C6.1, C12.1, C13.1, C14.1, C15.1, C16.1, C17.1, C18.1, C19.1, C20.1, C21.1, C22.1, C23.1, C24.1, C25.1, C26.1, J2.1, R1.1, R3.1, R13.1, R17.1, R18.1, R19.1, U1.5 (IOVDD), U1.15 (IOVDD), U1.24 (IOVDD), U1.29 (IOVDD), U1.41 (IOVDD), U1.50 (IOVDD), U1.59 (ADC_AVDD), U1.60 (IOVDD), U1.64 (VREG_VIN), U1.68 (USB_OTP_VDD), U1.69 (QSPI_IOVDD), U1.76 (IOVDD), U2.2 (OUT), U2.4 (OUT), U3.8 (VCC), U4.8 (VCC), U5.14 (VDDIO), U5.16 (VIN), U6.2 (VCC); also elsewhere on the board
/FLASH_SS: R1.2, R10.2, U3.1 (~CS)
/GPIO0: U1.77 (GPIO0); also elsewhere on the board
/GPIO1: U1.78 (GPIO1); also elsewhere on the board
/GPIO2: U1.79 (GPIO2); also elsewhere on the board
/GPIO3: U1.80 (GPIO3); also elsewhere on the board
/GPIO4: U1.1 (GPIO4); also elsewhere on the board
/GPIO5: U1.2 (GPIO5); also elsewhere on the board
/GPIO6: U1.3 (GPIO6); also elsewhere on the board
/GPIO7: U1.4 (GPIO7); also elsewhere on the board
/GPIO8: U1.6 (GPIO8); also elsewhere on the board
/GPIO9: U1.7 (GPIO9); also elsewhere on the board
/GPIO10: U1.8 (GPIO10); also elsewhere on the board
/GPIO11: U1.9 (GPIO11); also elsewhere on the board
/GPIO12: U1.11 (GPIO12); also elsewhere on the board
/GPIO13: U1.12 (GPIO13); also elsewhere on the board
/GPIO14: U1.13 (GPIO14); also elsewhere on the board
/GPIO15: U1.14 (GPIO15); also elsewhere on the board
/GPIO16: U1.16 (GPIO16); also elsewhere on the board
/GPIO17: U1.17 (GPIO17); also elsewhere on the board
/GPIO18: U1.18 (GPIO18); also elsewhere on the board
/GPIO19: U1.19 (GPIO19); also elsewhere on the board
/GPIO20: U1.20 (GPIO20); also elsewhere on the board
/GPIO21: U1.21 (GPIO21); also elsewhere on the board
/GPIO22: U1.22 (GPIO22); also elsewhere on the board
/GPIO23: U1.23 (GPIO23); also elsewhere on the board
/GPIO24: U1.25 (GPIO24); also elsewhere on the board
/GPIO25: U1.26 (GPIO25); also elsewhere on the board
/GPIO26: U1.27 (GPIO26); also elsewhere on the board
/GPIO27: U1.28 (GPIO27); also elsewhere on the board
/GPIO28: U1.36 (GPIO28); also elsewhere on the board
/GPIO29: U1.37 (GPIO29); also elsewhere on the board
/GPIO30: U1.38 (GPIO30); also elsewhere on the board
/GPIO31: U1.39 (GPIO31); also elsewhere on the board
/GPIO32: R17.2, U1.40 (GPIO32), U6.15 (SDA)
/GPIO33: R18.2, U1.42 (GPIO33), U6.16 (SCL)
/GPIO34: R19.2, U1.43 (GPIO34), U6.3 (~INT/SQW)
/GPIO35: J2.2, U1.44 (GPIO35)
/GPIO36: J2.3, U1.45 (GPIO36)
/GPIO37: J2.4, U1.46 (GPIO37)
/GPIO38: J2.5, U1.47 (GPIO38)
/GPIO39: J2.6, U1.48 (GPIO39)
/GPIO40_ADC0: J2.7, U1.49 (GPIO40_ADC0)
/GPIO41_ADC1: J2.8, U1.52 (GPIO41_ADC1)
/GPIO42_ADC2: J2.9, U1.53 (GPIO42_ADC2)
/GPIO43_ADC3: U1.54 (GPIO43_ADC3), U5.12 (WL_ON), U5.13 (BT_ON)
/GPIO44_ADC4: U1.55 (GPIO44_ADC4), U5.9 (~CS)
/GPIO45_ADC5: R14.1, R15.1, U1.56 (GPIO45_ADC5), U5.5 (DI)
/GPIO46_ADC6: U1.57 (GPIO46_ADC6), U5.3 (SCLK)
/GPIO47_ADC7: R11.1, U1.58 (GPIO47_ADC7)
/PSRAM_CS: R11.2, R13.2, U4.1 (~CS)
/QSPI_SCLK: U1.71 (QSPI_SCLK), U3.6 (CLK), U4.6 (CLK)
/QSPI_SD0: U1.72 (QSPI_SD0), U3.5 (DI_IO0), U4.5 (DI_IO0)
/QSPI_SD1: U1.74 (QSPI_SD1), U3.2 (DO_IO1), U4.2 (DO_IO1)
/QSPI_SD2: U1.73 (QSPI_SD2), U3.3 (~WP_IO2), U4.3 (~WP_IO2)
/QSPI_SD3: U1.70 (QSPI_SD3), U3.7 (~HOLD_IO3), U4.7 (~HOLD_IO3)
/QSPI_SS: R6.1, R10.1, U1.75 (QSPI_~SS)
/RUN: SW2.2, U1.35 (RUN)
/SWCLK: J3.1, U1.33 (SWCLK)
/SWD: J3.3, U1.34 (SWDIO)
/USB_D+: J1.A6 (D+), J1.B6 (D+), R7.1
/USB_D-: J1.A7 (D-), J1.B7 (D-), R8.1
/VREG_AVDD: C9.1, R3.2, U1.61 (VREG_AVDD)
/VREG_LX: L1.2, U1.63 (VREG_LX)
/WL_GPIO1: J9.1, U5.18 (GPIO1)
/WL_GPIO2: J9.2, U5.17 (GPIO2)
/XIN: C3.1, U1.30 (XIN), X1.1
/XOUT: R2.1, U1.31 (XOUT)
/~USB_BOOT: R6.2, SW1.2
GND: BT1.2 (-), C1.2, C2.2, C3.2, C4.2, C5.2, C6.2, C7.2, C8.2, C9.2, C10.2, C11.2, C12.2, C13.2, C14.2, C15.2, C16.2, C17.2, C18.2, C19.2, C20.2, C21.2, C22.2, C23.2, C24.2, C25.2, C26.2, D1.1 (K), J1.A1 (GND), J1.A12 (GND), J1.B1 (GND), J1.B12 (GND), J1.SH (SHIELD), J2.10, J3.2, J9.3, R4.2, R56.2, R57.2, SW1.1, U1.62 (VREG_PGND), U1.81 (GND), U2.1 (GND), U3.4 (GND), U4.4 (GND), U5.1 (GND), U5.4 (GND), U5.7 (GND), U5.11 (GND), U5.15 (GND), U5.21 (GND), U6.5 (GND), U6.6 (GND), U6.7 (GND), U6.8 (GND), U6.9 (GND), U6.10 (GND), U6.11 (GND), U6.12 (GND), U6.13 (GND), X1.2, X1.4; also elsewhere on the board
unnamed: BT1.1 (+), U6.14 (VBAT)
unnamed: C4.1, R2.2, X1.3
unnamed: D1.2 (A), R16.2
unnamed: J1.A5 (CC1), R56.1
unnamed: J1.B5 (CC2), R57.1
unnamed: R4.1, SW2.1
unnamed: R8.2, U1.66 (USB_DM)
unnamed: R7.2, U1.67 (USB_DP)
unnamed: R14.2, U5.6 (DO)
unnamed: R16.1, U5.8 (GPIO0)
unnamed: R15.2, U5.10 (~IRQ)
VBUS: D2.2 (A), J1.A4 (VBUS), J1.A9 (VBUS), J1.B4 (VBUS), J1.B9 (VBUS)
VSYS: C1.1, D2.1 (K), U2.3 (IN); also elsewhere on the board

Notes on the sheet:
8 MB PSRAM (U4) on the second QSPI chip select (XIP_SS_N[1]), moved from GPIO0 to GPIO47. R13 pull-up keeps it deselected at power-up (GPIOs default to pull-downs). Fit R11 = 0R.
RTC and headers
If using RP2354 (internal flash), remove R10. R9 can be fit to use U3 as secondary memory.
Note: S1 schematic revision indicates that this is the 1st revision of the schematic/BOM associated with the R4 PCB. R4-S1 therefore uniquely identifies the fully built PCB Assembly (PCBA). This is a change from the previous revision numbering to align with the internal Raspberry Pi product revisio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
Radio (RM2)
RUN Button
RM2 gSPI: GPIO43 = WL_ON + BT_ON, GPIO44 = CS, GPIO45 = DATA (DI direct, DO through R14, IRQ through R15), GPIO46 = CLK. Same circuit as the Pico 2 W, moved off GPIO23/24/25/29; set CYW43_DEFAULT_PIN_* in the board header. Hand-solder U5 (not stocked at LCSC). Keep copper out from under the antenna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
Primary Flash
BOOTSEL Button
12MHz Crystal
Make sure R7 and R8 are close to RP2350
PSRAM
Power
VSYS comes from the 12 V input: buck to +5V, then D4 (Power sheet). D2 keeps that 5 V off the USB port; USB alone runs it through D2 (no +5V on ribbons).
RTC: the DS3231 circuit from universal-strip-controller (U9), on I2C0: SDA = GPIO32, SCL = GPIO33, INT/SQW = GPIO34 (open drain, pulled up). 32KHZ and RST unused. CR1220 in a Keystone 3001 holder.
J2: spare GPIO35-42. UART1 TX/RX = GPIO36/37, GPIO40-42 = ADC0-2. J3: SWD in a Pico's debug pin order. GPIO0-31 go to the four output shrouds (Outputs sheet). GPIO43-47 are the RM2 and the PSRAM.
CC1/CC2 5.1k pull-downs: a USB-C host sees a USB 2.0 device and turns on 5 V.
GPIO0-31 to the four output shrouds
12 V in, 5 V buck

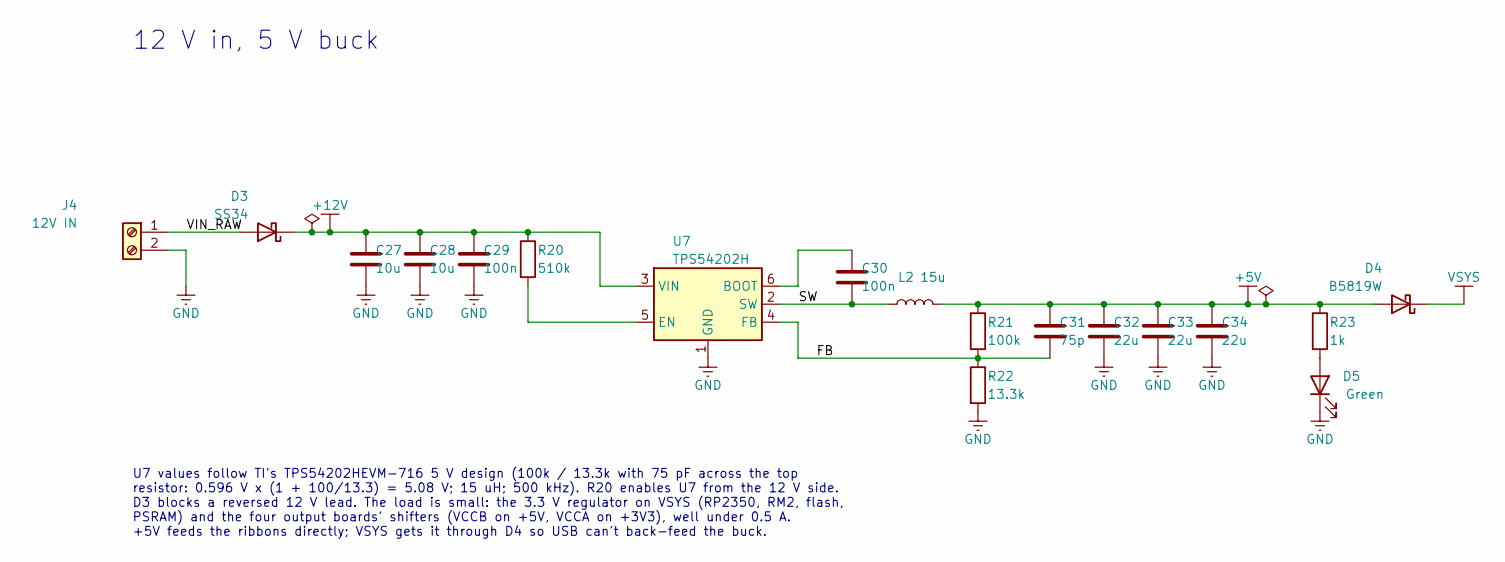
[picture p16: schematic Power.kicad_sch, LED processor board: Power]

Parts:
C27, C28: 10u; C_0805_2012Metric; manufacturer_pn CL21A106KBYNNNE; LCSC C440198
C29, C30: 100n; C_0603_1608Metric; manufacturer_pn CC0603KRX7R9BB104; LCSC C14663
C31: 75p; C_0402_1005Metric; manufacturer_pn 0402CG750J500NT; LCSC C37809
C32, C33, C34: 22u; C_0805_2012Metric; manufacturer_pn CL21A226MAQNNNE; LCSC C45783
D3: SS34; D_SMA; manufacturer_pn SS34; LCSC C8678
D4: B5819W; D_SOD-123; manufacturer_pn B5819W SL; LCSC C8598
D5: Green; LED_0603_1608Metric; manufacturer_pn KT-0603YG; LCSC C2289
J4: 12V IN; TerminalBlock_Phoenix_PT-1,5-2-3.5-H_1x02_P3.50mm_Horizontal; manufacturer_pn DB301V-3.5-2P-GN-S; LCSC C695629
L2: 15u; L_Sunlord_SWPA8040S; manufacturer_pn SWPA8040S150MT; LCSC C16853
R20: 510k; R_0402_1005Metric; manufacturer_pn 0402WGF5103TCE; LCSC C11616
R21: 100k; R_0402_1005Metric; manufacturer_pn 0402WGF1003TCE; LCSC C25741
R22: 13.3k; R_0402_1005Metric; manufacturer_pn 0402WGF1332TCE; LCSC C122547
R23: 1k; R_0402_1005Metric; manufacturer_pn 0402WGF1001TCE; LCSC C11702
U7: TPS54202H; SOT-23-6; manufacturer_pn TPS54202HDDCR; LCSC C527684

Connections:
+5V: C31.1, C32.1, C33.1, C34.1, D4.2 (A), L2.2, R21.1, R23.1; also elsewhere on the board
+12V: C27.1, C28.1, C29.1, D3.1 (K), R20.1, U7.3 (VIN)
/Power/FB: C31.2, R21.2, R22.1, U7.4 (FB)
/Power/SW: C30.2, L2.1, U7.2 (SW)
/Power/VIN_RAW: D3.2 (A), J4.1
GND: C27.2, C28.2, C29.2, C32.2, C33.2, C34.2, D5.1 (K), J4.2, R22.2, U7.1 (GND); also elsewhere on the board
unnamed: D5.2 (A), R23.2
unnamed: C30.1, U7.6 (BOOT)
unnamed: R20.2, U7.5 (EN)
VSYS: D4.1 (K); also elsewhere on the board

Notes on the sheet:
12 V in, 5 V buck
U7 values follow TI's TPS54202HEVM-716 5 V design (100k / 13.3k with 75 pF across the top resistor: 0.596 V x (1 + 100/13.3) = 5.08 V; 15 uH; 500 kHz). R20 enables U7 from the 12 V side. D3 blocks a reversed 12 V lead. The load is small: the 3.3 V regulator on VSYS (RP2350, RM2, flash, PSRAM) and t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

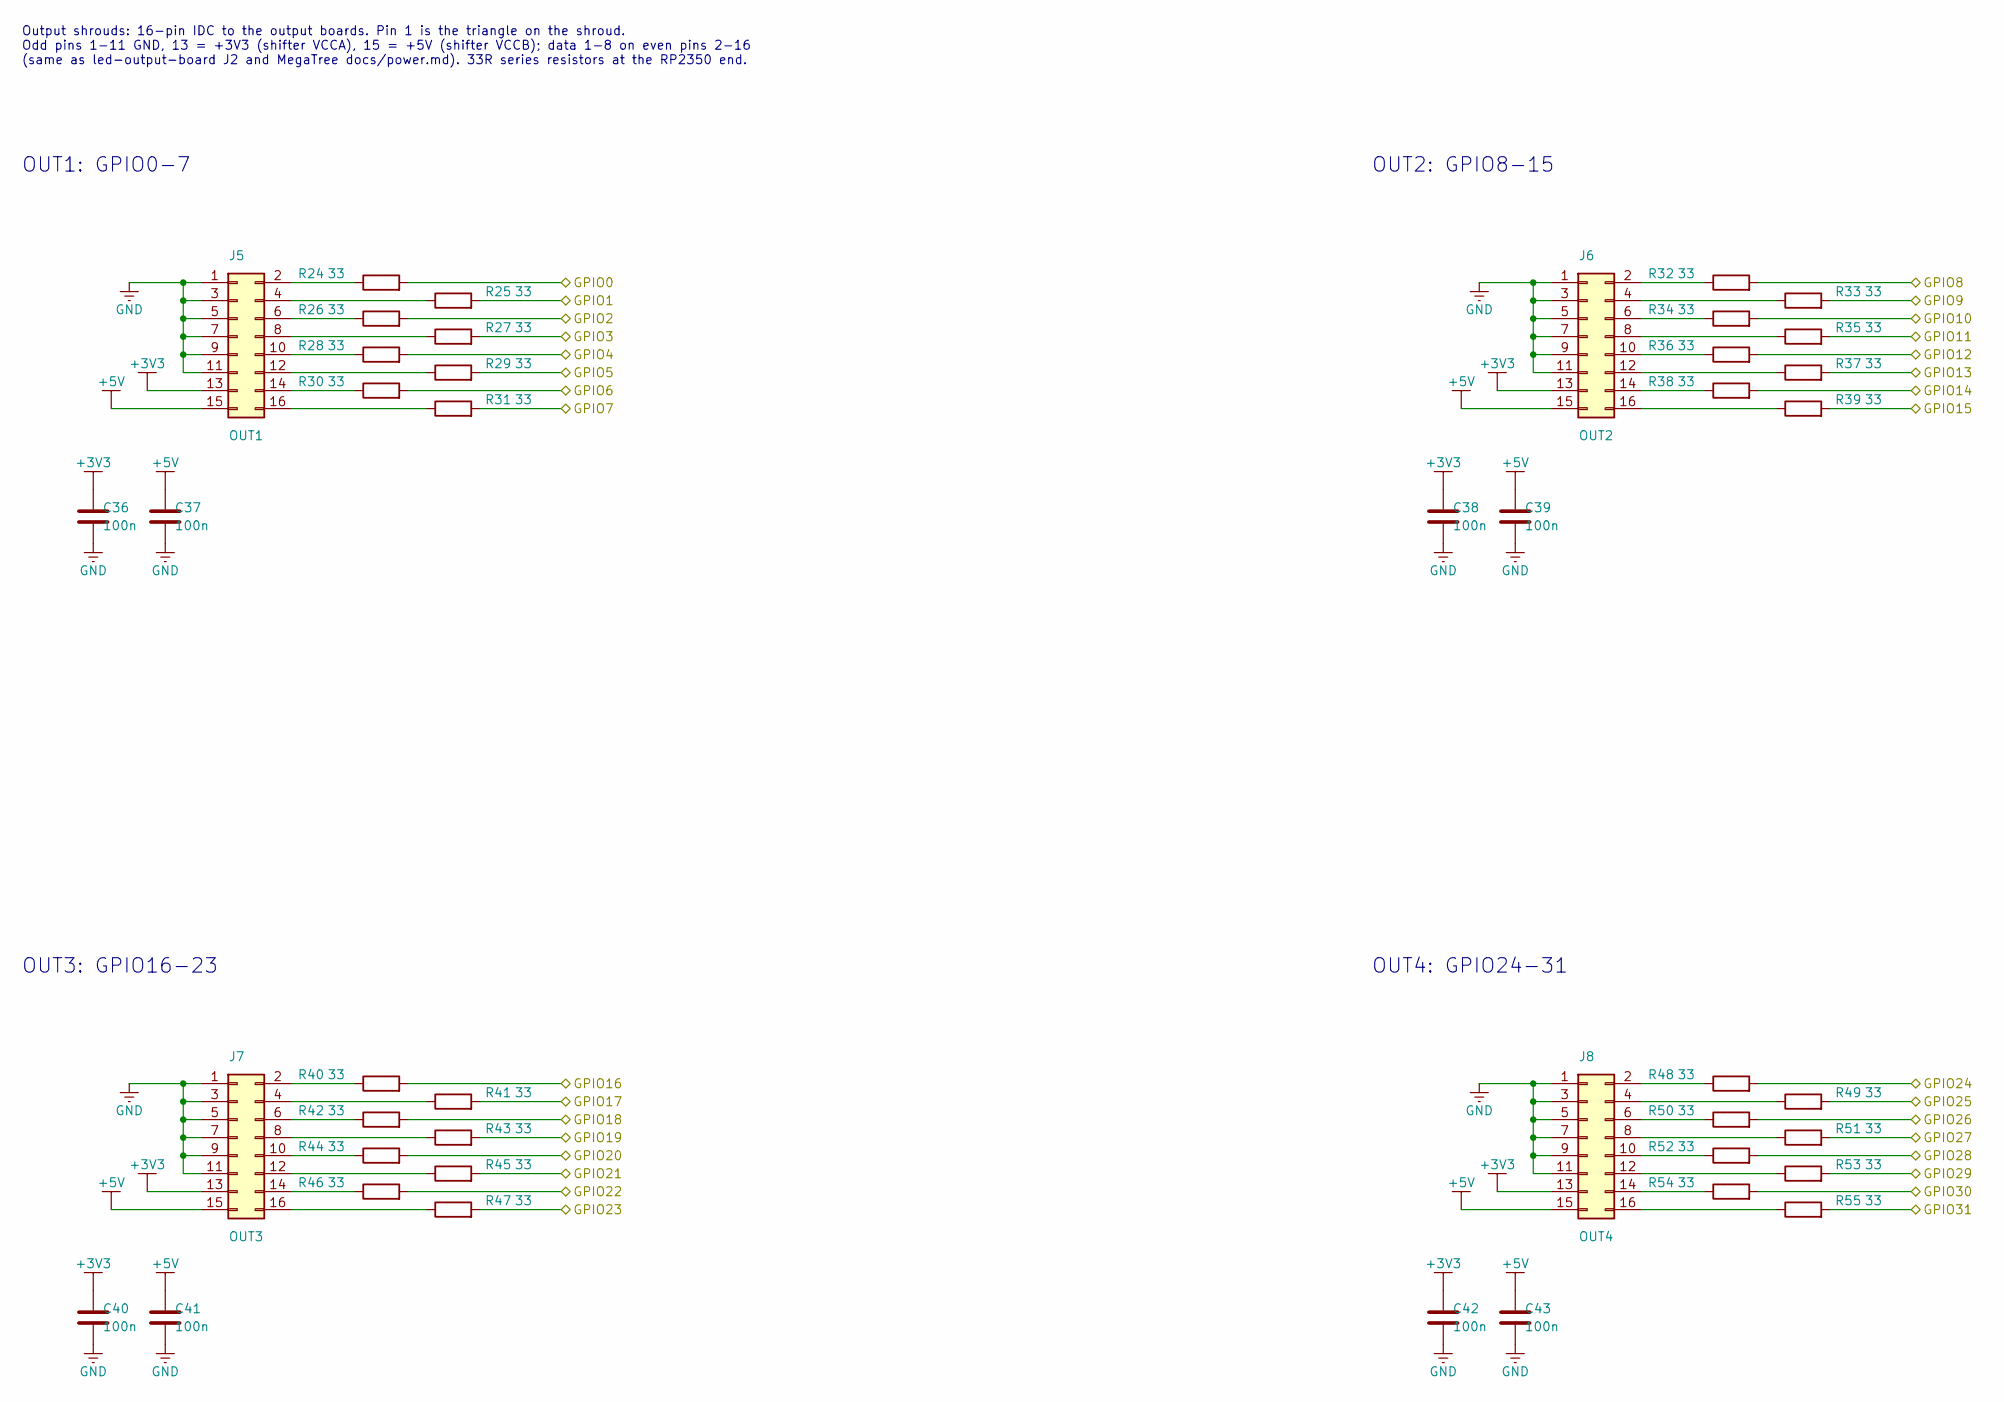
[picture p17: schematic Outputs.kicad_sch, LED processor board: Outputs]

Parts:
C36, C37, C38, C39, C40, C41, C42, C43: 100n; C_0402_1005Metric; manufacturer_pn CL05B104KO5NNNC; LCSC C1525
J5: OUT1; IDC-Header_2x08_P2.54mm_Vertical; manufacturer_pn Box header 2x08 2.54 mm
J6: OUT2; IDC-Header_2x08_P2.54mm_Vertical; manufacturer_pn Box header 2x08 2.54 mm
J7: OUT3; IDC-Header_2x08_P2.54mm_Vertical; manufacturer_pn Box header 2x08 2.54 mm
J8: OUT4; IDC-Header_2x08_P2.54mm_Vertical; manufacturer_pn Box header 2x08 2.54 mm
R24, R25, R26, R27, R28, R29, R30, R31, R32, R33, R34, R35, R36, R37, R38, R39, R40, R41, R42, R43, R44, R45, R46, R47, R48, R49, R50, R51, R52, R53, R54, R55: 33; R_0402_1005Metric; manufacturer_pn 0402WGF330JTCE; LCSC C25105

Connections:
+3V3: C36.1, C38.1, C40.1, C42.1, J5.13, J6.13, J7.13, J8.13; also elsewhere on the board
+5V: C37.1, C39.1, C41.1, C43.1, J5.15, J6.15, J7.15, J8.15; also elsewhere on the board
/GPIO0: R24.2; also elsewhere on the board
/GPIO1: R25.2; also elsewhere on the board
/GPIO2: R26.2; also elsewhere on the board
/GPIO3: R27.2; also elsewhere on the board
/GPIO4: R28.2; also elsewhere on the board
/GPIO5: R29.2; also elsewhere on the board
/GPIO6: R30.2; also elsewhere on the board
/GPIO7: R31.2; also elsewhere on the board
/GPIO8: R32.2; also elsewhere on the board
/GPIO9: R33.2; also elsewhere on the board
/GPIO10: R34.2; also elsewhere on the board
/GPIO11: R35.2; also elsewhere on the board
/GPIO12: R36.2; also elsewhere on the board
/GPIO13: R37.2; also elsewhere on the board
/GPIO14: R38.2; also elsewhere on the board
/GPIO15: R39.2; also elsewhere on the board
/GPIO16: R40.2; also elsewhere on the board
/GPIO17: R41.2; also elsewhere on the board
/GPIO18: R42.2; also elsewhere on the board
/GPIO19: R43.2; also elsewhere on the board
/GPIO20: R44.2; also elsewhere on the board
/GPIO21: R45.2; also elsewhere on the board
/GPIO22: R46.2; also elsewhere on the board
/GPIO23: R47.2; also elsewhere on the board
/GPIO24: R48.2; also elsewhere on the board
/GPIO25: R49.2; also elsewhere on the board
/GPIO26: R50.2; also elsewhere on the board
/GPIO27: R51.2; also elsewhere on the board
/GPIO28: R52.2; also elsewhere on the board
/GPIO29: R53.2; also elsewhere on the board
/GPIO30: R54.2; also elsewhere on the board
/GPIO31: R55.2; also elsewhere on the board
GND: C36.2, C37.2, C38.2, C39.2, C40.2, C41.2, C42.2, C43.2, J5.1, J5.3, J5.5, J5.7, J5.9, J5.11, J6.1, J6.3, J6.5, J6.7, J6.9, J6.11, J7.1, J7.3, J7.5, J7.7, J7.9, J7.11, J8.1, J8.3, J8.5, J8.7, J8.9, J8.11; also elsewhere on the board
unnamed: J5.2, R24.1
unnamed: J5.4, R25.1
unnamed: J5.6, R26.1
unnamed: J5.8, R27.1
unnamed: J5.10, R28.1
unnamed: J5.12, R29.1
unnamed: J5.14, R30.1
unnamed: J5.16, R31.1
unnamed: J6.2, R32.1
unnamed: J6.4, R33.1
unnamed: J6.6, R34.1
unnamed: J6.8, R35.1
unnamed: J6.10, R36.1
unnamed: J6.12, R37.1
unnamed: J6.14, R38.1
unnamed: J6.16, R39.1
unnamed: J7.2, R40.1
unnamed: J7.4, R41.1
unnamed: J7.6, R42.1
unnamed: J7.8, R43.1
unnamed: J7.10, R44.1
unnamed: J7.12, R45.1
unnamed: J7.14, R46.1
unnamed: J7.16, R47.1
unnamed: J8.2, R48.1
unnamed: J8.4, R49.1
unnamed: J8.6, R50.1
unnamed: J8.8, R51.1
unnamed: J8.10, R52.1
unnamed: J8.12, R53.1
unnamed: J8.14, R54.1
unnamed: J8.16, R55.1

Notes on the sheet:
Output shrouds: 16-pin IDC to the output boards. Pin 1 is the triangle on the shroud. Odd pins 1-11 GND, 13 = +3V3 (shifter VCCA), 15 = +5V (shifter VCCB); data 1-8 on even pins 2-16 (same as led-output-board J2 and MegaTree docs/power.md). 33R series resistors at the RP2350 end.
OUT1: GPIO0-7
OUT2: GPIO8-15
OUT3: GPIO16-23
OUT4: GPIO24-31

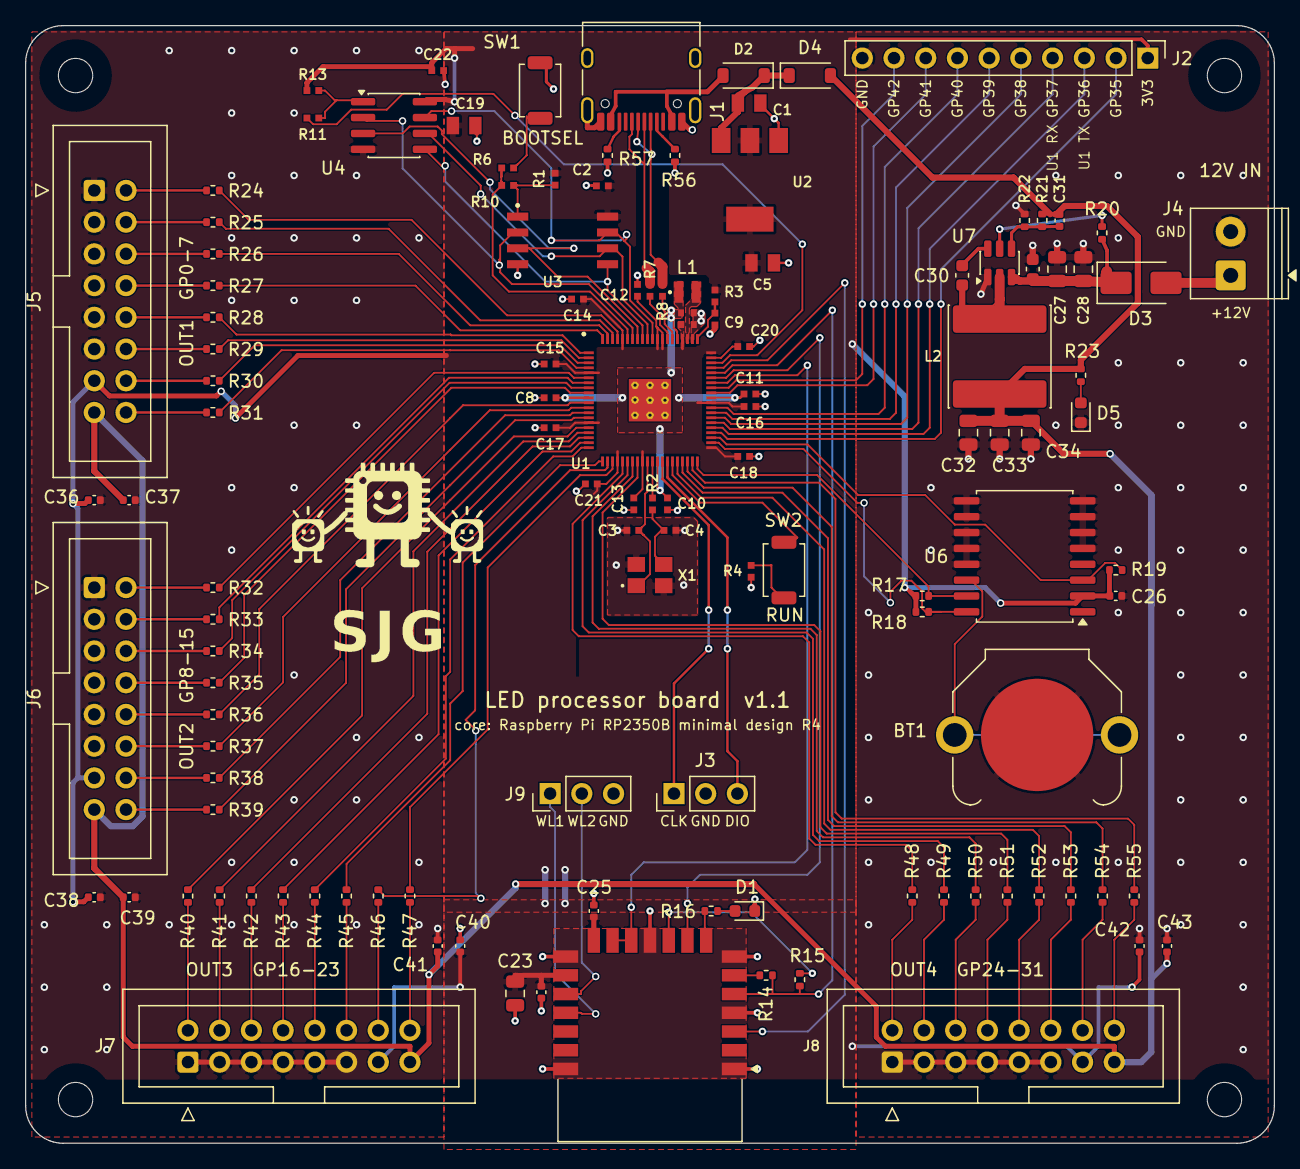
[picture p18: board led-processor-board.kicad_pcb from above]

Board: 2 copper layers, 100.0 x 89.5 mm, 128 parts (0 on the bottom side), 124 nets.

Other parts of the board:
G1: SJG_BigBrother
