eelstretching/led-processor-board/(commit log)

2026-10-19 Processor board schematic: RP2350B + RM2 core, DS3231 RTC, four output shrouds
    Starts from eelstretching/rp2350b-rm2-reference (RP2350B, flash, PSRAM,
    RM2, USB) and replaces its J2/J3 headers with:
    - DS3231SN RTC on I2C0 (GPIO32/33, INT on GPIO34), circuit from
    universal-strip-controller, CR1220 in a Keystone 3001 holder
    - four 16-pin IDC shrouds (J5-J8) with the output boards' pinout,
    GPIO0-31 in order through 33R series resistors
    - 12 V input, SS34 reverse protection, TPS54202H buck to +5V for the
    ribbons and (through B5819W) VSYS
    - spare GPIO35-42 header and a 3-pin SWD header
    ERC matches the reference (only Pi's inherited items). Includes a JLCPCB
    BOM, PDF/PNG previews and the gen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
    [Outputs.kicad_sch, Power.kicad_sch, bom-jlcpcb.csv, led-processor-board.kicad_sch]
2026-10-19 Use a USB-C receptacle instead of the micro-B
    J1 is now a Korean Hroparts TYPE-C-31-M-12 (LCSC C165948, stock KiCad
    footprint), USB 2.0: D+/D- from both sides joined, 5.1k pull-downs on
    CC1/CC2 (R56, R57), SBU unconnected, shell to GND. VBUS still feeds D2.
    PWR_FLAGs on VBUS and GND replace the drive the old symbol's power pins
    gave; ERC is unchanged (only Pi's inherited items).
    Claude-Session: https://claude.ai/code/session_01CYnkeL97vxsPSCyXSKGro9
    [Outputs.kicad_sch, Power.kicad_sch, bom-jlcpcb.csv, led-processor-board.kicad_sch]
2026-10-19 Wire the 33R resistors straight to the shroud pins
    Drops the OUTk_Dn net labels between each shroud pin and its resistor.
    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
    [Outputs.kicad_sch]
2026-10-19 First PCB layout: Pi's core plus shrouds, buck, USB-C and RTC
    Two layers, 100 x 89.5 mm. Pi's RP2350B/RM2 core keeps its placement and
    routing (PSRAM still on the bottom, as on the reference board). The four
    output shrouds go down the left edge and along the bottom, the 12 V buck
    and input in the top right, the RTC on the right, USB-C where the micro-B
    was. Power, USB-C, the OUT4 and RM2 buses and SWD are hand-routed; the rest
    is Freerouting 1.9.0. DRC: nothing unconnected, no copper errors.
    The scripts that built it are in tools/pcb/.
    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
    [led-processor-board.kicad_pcb]
2026-10-20 Move the PSRAM to the top side for one-sided JLCPCB assembly
    U4 (APS6404L) and its C22, R11 and R13 were under the flash on the bottom,
    as on Pi's board. They now sit on top just left of the flash, with the
    QSPI branches run from Pi's vias under U3, so every part is on the top.
    DRC: nothing unconnected, no copper errors.
    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
    [led-processor-board.kicad_pcb]
2026-10-20 Move the spare GPIO header (J2) to the top edge
    J2 now sits along the top edge right of the USB-C, so wires leave from
    the board edge. GPIO35-42 are hand-routed: top-layer escapes from the
    core, a via row left of the buck, then a bottom-layer fan-out to the
    pins, with the ADC lanes (GPIO40-42) furthest from the switch node.
    The +3V3 hop from the core pour to the RTC moves below the via row.
    post.py keeps stitching vias off silkscreen text.
    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
    [led-processor-board.kicad_pcb]
2026-10-20 Bottom shrouds to the edge; add J9 for the RM2's spare GPIOs
    J7/J8 move down until their bottom pins sit just above the antenna
    strip, like the left-edge shrouds; J8 also shifts 1.6 mm left to clear
    the corner hole. Their 3V3/5V runs are hand-routed through the channel
    between the pin rows (one net per layer) and the caps sit above the
    shrouds' right ends. This replaces the old OUT4 3V3 run along the
    bottom edge into the radio's 3V3 pour.
    J9 (1x3: WL_GPIO1, WL_GPIO2, GND) breaks out the CYW43's two unused
    GPIOs beside the RM2, in the schematic and on the board; C23/C24 move
    up to make room. DRC with schematic parity is clean apart from the
    inherited warnings.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
    [bom-jlcpcb.csv, led-processor-board.kicad_pcb, led-processor-board.kicad_sch]
2026-10-20 Move J9 and the SWD header (J3) under the board name
    Both 1x3 headers now sit side by side in the open area under the board
    name, J9 (WL_GPIO1, WL_GPIO2, GND) on the left and J3 (SWCLK, GND, SWD)
    on the right, with pin labels under each. C23/C24 go back to Pi's
    spots beside the RM2. SWCLK/SWD keep their escapes from the core and
    hop under the GPIO24-27 run on the bottom layer; WL_GPIO1/2 run up on
    the bottom layer. DRC with schematic parity is unchanged.
    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
    [led-processor-board.kicad_pcb]
2026-10-20 LCSC buttons, and JLCPCB files for SMD-only assembly
    SW1/SW2 become the XKB TS-1088R-02526 (LCSC C455281) in Pi's spots, with
    the schematic symbols swapped to Switch:SW_Push. tools/jlc.py writes fab/:
    gerbers + drill zip, and a BOM and CPL with only the SMD parts JLC places.
    The RM2, battery holder, headers, shrouds and J4 are left to hand-solder.
    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
    [bom-jlcpcb.csv, jlcpcb-bom.csv, led-processor-board.kicad_pcb, led-processor-board.kicad_sch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]
2026-10-20 Move the BOMs and JLCPCB files into production/
    bom-jlcpcb.csv becomes production/bom-full.csv, next to the JLC
    assembly BOM, CPL and gerbers zip (was fab/). tools/jlc.py reads and
    writes there.
    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
    [bom-full.csv, jlcpcb-bom.csv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]
2026-10-21 Remove R9 and the dead GPIO0 branch to it
    R9 is Pi's unfitted 0R option from GPIO0 to the flash chip select. It was
    DNP here too, so its only effect was a stub on OUT1's first data line.
    Dropped from the schematic and board with its wiring; JLC files and
    previews regenerated (assembly BOM/CPL unchanged).
    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
    [led-processor-board.kicad_pcb, led-processor-board.kicad_sch]
2026-10-21 Straighten GPIO0 and chamfer GPIO1 on the way to OUT1
    GPIO0 still jogged up to where R9's via was; it now runs straight to
    OUT1's resistor. GPIO1's right-angle corner gets a 45-degree chamfer.
    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
    [led-processor-board.kicad_pcb]
2026-10-21 Fix two duplicate symbol references so the schematic is fully annotated
    #FLG01 and #FLG1 count as the same reference to KiCad, and J9's GND
    reused #PWR116 from the Power sheet. They become #FLG6 and #PWR157, so
    DRC's schematic parity check runs instead of refusing. No net or board
    change.
    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
    [led-processor-board.kicad_sch]
2026-10-21 Added labels to the UART RX and TX that we'll need to use for debugging
    [led-processor-board.kicad_pcb]
2026-10-21 Regenerate JLC files from the board with UART labels; add Mac steps for jlc.py
    Gerbers and previews rebuilt from 22c8b20 (UART labels, GPIO0/GPIO1
    reroute). BOM and CPL are unchanged. README now says how to run
    tools/jlc.py with KiCad's bundled Python on a Mac.
    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
2026-10-22 Merge JLC BOM lines that share an LCSC part
    JLC flags "multiple lines matched to the same part" and zeroes the
    duplicates when one part appears on two lines (the Pi core and our
    sheets use different footprint names for the same 0402/0805 parts).
    jlc.py now writes one line per LCSC number. Same 112 parts, 33 lines.
    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
    [jlcpcb-bom.csv]
2026-10-22 Leave L1 off the JLC files for hand-soldering
    The Abracon AOTA-B201610S3R3-101-T is out of stock at LCSC and global
    sourcing would delay the order by weeks, so Steve hand-solders it.
    JLC now assembles 111 parts.
    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
    [jlcpcb-bom.csv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]
2026-10-22 Swap D1/D5 to KENTO KT-0603YG (C2289)
    The Everlight green LED (C72043) is short at JLC. KT-0603YG is a
    yellow-green 0603 with a 2.0-2.2 V forward drop, so D1 (WL_GPIO0, 3.3 V)
    and D5 (+5V) through their 1k resistors are brighter than before.
    Schematic, board fields and bom-full.csv updated; DRC parity clean.
    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
    [Power.kicad_sch, bom-full.csv, jlcpcb-bom.csv, led-processor-board.kicad_pcb, led-processor-board.kicad_sch]
2026-10-22 Correct JLC placement rotations for U2, U3, U4 and U6
    JLC's preview showed the SOT-223 regulator and the three SOICs a quarter
    turn off their pads (rotated by hand for the first order). ROT_FIX in
    jlc.py now applies the same -90 deg so the CPL is right as uploaded.
    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
    [jlcpcb-cpl.csv]
2026-10-25 Add DS3231 firmware with per-board RTC pins
    Move the Ds3231 driver over from universal-strip-controller's firmware and
    add rtc_pins.h, which picks the RTC bus from PICO_BOARD: I2C0 GPIO32/33 on
    the processor board, I2C1 GP26/27 on the perfboard Pico 2 W. A pin on the
    wrong I2C peripheral fails the build.
    rtc_set sets the RTC (UTC) over USB serial from Unix seconds or a date, and
    scans the bus when the chip doesn't answer; tools/set_rtc.py sends the
    laptop's clock on the second. wifi_rtc_sync is ported to the same pins.
    boards/led_processor_board.h is rp2350b_rm2.h plus the RTC pins and UART1
    on GPIO36/37.
    Claude-Session: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
    [led_processor_board.h, lwipopts.h, main.cpp, rtc_pins.h]
2026-10-25 rtc_set: ignore junk bytes on the serial line
    The first try on the perfboard Pico 2 W answered 'Didn't understand ""'
    to a good Unix time: stdio was also reading UART0, whose RX pin (GP1)
    floats there, and a stray NUL in front of the digits made the line both
    print as empty and fail to parse. Read USB only, drop non-printable
    bytes, and parse the Unix time with strtoll.
    Claude-Session: https://claude.ai/code/session_01P384C7Urw715KSUtZBDXkE
    [main.cpp]
2026-10-25 rtc_set: seed a powerless RTC with the build time in UTC
    __DATE__/__TIME__ are the build machine's local time, so a build on
    Steve's Mac seeded the fresh DS3231 with EDT. Take the build time from
    CMake's UTC timestamp instead.
    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
2026-10-25 set_rtc.py: don't hang on a Mac /dev/tty.* port
    open() on /dev/tty.usbmodem* waits for carrier detect, which a Pico never
    raises, so the script hung silently unless another program already had
    the port open. Switch to the /dev/cu.* twin and open non-blocking.
    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
2026-10-25 rtc_set: print US Eastern time next to UTC
    The RTC stays on UTC; only the printout adds local time, via newlib's
    POSIX TZ rules (EST5EDT,M3.2.0,M11.1.0) so the EDT/EST switch is
    automatic. Override with -DLOCAL_TZ.
    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
2026-10-28 v1.1 silkscreen: put every reference next to its own part
    L1 (hand-soldered core inductor) gets a 1 mm label right above it and its
    pin-1 dot moves to the middle of pad 1's side. The rest of the refs are
    re-placed by tools/pcb/silk_near.py, which keeps each label nearest its own
    part and clear of pads, silk and other labels; the dense spots (R7/R8,
    buck feedback row, OUT3/OUT4 series resistors, J5/J6) are placed by hand in
    its FIXED table. C6, C7 and C29 stay unlabelled (no spot that reads
    clearly). Board text now says v1.1.
    tools/pcb/silk_preview.py renders the silkscreen as fabbed; before/after
    images in docs/silk-v1.1/. DRC: same 4 silk-edge warnings and 42 library
    warnings as v1, no new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
    [led-processor-board.kicad_pcb]
2026-10-28 Add the SJG big-brother logo to the silkscreen
    The chip guy holding hands with two LED guys (the output board's mascot),
    16 mm tall, in the empty space left of the RP2350 at (79, 113). Source SVG
    in docs/logo/; tools/pcb/svg_logo.py turns it into logos.pretty/
    SJG_BigBrother.kicad_mod (filled F.SilkS polygons, board-only, excluded
    from BOM and position files). DRC: no new items.
    Claude-Session: https://claude.ai/code/session_01NSi48cydvQ6UvBo4im78hn
    [led-processor-board.kicad_pcb]
2026-10-29 Add bringup: first power-on test for the processor board
    Toggles GP35 on J2 at 1 Hz (the only blinkable pin before the RM2 is fitted;
    D5 is the +5V LED and D1 is on WL_GPIO0), blinks D1 with it once the RM2 is
    there, and reports chip, clocks, flash ID, die temperature, the DS3231 and the
    radio's state over USB serial. Leaves GPIO 0-31 alone.
    Claude-Session: https://claude.ai/code/session_01NSi48aXRGuR85Xf9n3FzZJ
2026-10-30 strand_test: count a strand's pixels on GP3
    GP3 lights 190 pixels green, then adds the last 10 in red one per second, holds all 200 for
    5 s and repeats, so a strand that's short shows fewer than ten red pixels. GP2 is unchanged.
    Claude-Session: https://claude.ai/code/session_01NSi48ZyxRukznUqQsddund
    [main.cpp]
2026-10-31 bringup: report a missing RM2, build only for the processor board
    cyw43_arch_init() succeeds without a radio chip because the chip is only
    brought up on first use, so the report said "radio up" on a board with no
    RM2. Drive D1 once with cyw43_gpio_set() and use its result instead.
    Only add bringup to the build for PICO_BOARD=led_processor_board: a pico2_w
    build (the CMake default, e.g. from VS Code) ran on the board and looked for
    the RTC on I2C1 GP26/27, read GPIO44 as the temperature sensor (415 C), and
    couldn't toggle GP35.
    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
    [main.cpp]
2026-11-01 bringup: retry the radio until it answers, and report when it did
    While bringing up the first v1.0 board the RM2 sometimes failed to answer
    (cyw43 error -6) and later came up fine. Rather than give up on the first try,
    retry every 500 ms for up to 30 s, print each failed try, and report the try and
    time it came up. The status line now says "D1 blinking" instead of sampling
    D1's state a few ms before core 1 updated it.
    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
    [main.cpp]
2026-11-01 bringup: release the radio bus between retries
    A failed cyw43 bring-up keeps its gSPI PIO state machine and program, and
    cyw43_deinit() skips cleanup when the chip never came up, so every retry
    claimed another one until the PIOs ran out and later tries failed in 70 ms
    without touching the RM2. Call cyw43_ll_deinit() after each failed try.
    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
    [main.cpp]
2026-11-02 Add all_strands: 190 green + 10 red on all 32 outputs
    One PIO state machine drives GPIO 0-31 in parallel from a prebuilt
    DMA frame, resent every 20 ms, so a whole board of strands can be
    checked at once.
    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
2026-11-03 strand_test, all_strands: turn on USB serial
    Without USB stdio the board doesn't show up as a tty and picotool -f
    can't reboot it into BOOTSEL, so the only way back was the buttons.
    Both now enable USB stdio and print a status line every 5 s. README
    notes that every example should keep USB on.
    Claude-Session: https://claude.ai/code/session_01NSi48e4Vtvs7fjXmjWDUMg
    [main.cpp]
2026-11-06 Add pin_test: toggle GPIO 0-31 at 1 s for checking output-board level shifters
    D1 (RM2 LED) and GP35 follow the pins; USB stdio on for picotool -f.
    Claude-Session: https://claude.ai/code/session_01NSi48dNw8ueLZyKYrrbKjG
2026-11-06 Make led-processor-board the standard in VS Code
2026-11-06 bringup: print US Eastern time and the last reset reason
    Moves rtc_set's UTC-to-Eastern printout (POSIX TZ rules, DST included) into
    the ds3231 driver as rtc_local_time.h so bringup and rtc_set share it.
    Bringup's status line now shows the RTC in UTC and Eastern, and the full
    report gains a Reset line from POWMAN CHIP_RESET (power-on, brown-out, RUN
    pin, debugger, ...) plus the watchdog's reboot flag, so a press of RUN shows
    up as "RUN pin" after the reboot.
    Claude-Session: https://claude.ai/code/session_01NSi48ac6Jv9k74ViWiVcni
    [main.cpp]
2026-11-06 Add psram_test and uber_test, plus a shared PSRAM stress library
    drivers/psram_stress: data bus, address/wrap, byte lanes, fill/verify through
    the cached and uncached windows, DMA round trip and a benchmark. Turns on
    PICO_AUTO_DETECT_PSRAM_SIZE so the SDK only maps U4 if it answers its ID read.
    examples/psram_test: stress passes forever, alternating 150 and 200 MHz with
    the PSRAM re-timed each time, plus a two-core stage and a linker-section check.
    examples/uber_test: radio, WiFi and NTP on core 1; RTC set from NTP, Eastern
    clock, LEDs on GPIO 0-31 played from frames stored in PSRAM (DMA into SRAM
    double buffers, checksummed) and a rolling PSRAM stress on core 0. WiFi
    credentials from wifi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
2026-11-06 Add over-the-air updates: A/B flash slots, ota library, ota_test, push tool
    - firmware/ota/partitions.json: 16 MB layout with Firmware A/B (4 MB each), reserved WiFi
    firmware A/B, Settings and Show data partitions; top 16 KB left unpartitioned for the
    RP2350-E10 block and BTstack's flash bank.
    - drivers/ota: bootState()/commit() (rom_explicit_buy) and a lwIP TCP server on port 4242 that
    writes a pushed UF2 into the non-running slot, verifies every block and a SHA-256, then does a
    flash-update reboot so the bootrom runs it as a try-before-you-buy trial.
    - examples/ota_test: slow / fast / nobuy builds (TBYB images; commit only once WiFi and the update
    server are up; nobuy never commi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
    [lwipopts.h, main.cpp, ota.cpp, ota.hpp]
2026-11-07 Add rm2_pins: RM2 joint check (pull test, then hold GP43-46 high one at a time)
    Rebuilt from the rm2_pins .uf2 handed over on 2026-11-01, whose source was never pushed.
    Same output strings and behaviour: pull test on CS/DATA/CLK with WL_ON held low, then each
    line held high for 20 s with a probe label naming the RM2 castellation.
    Claude-Session: https://claude.ai/code/session_01NSi48arWyYRRdwBhW8h8sp
2026-11-07 Radio retry loops: actually retry after a failed try
    bringup, pin_test and uber_test looped `while (err == 0)`, so the first failed
    cyw43_gpio_set() ended the loop: every board reported "no RM2 after 1 tries" and the
    retries added in #17 never ran. Keep looping while a try has been made; a failed
    cyw43_arch_init() (before any try) still skips it.
    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
    [main.cpp]
2026-11-07 rm2_pins: hold each pin until a key, in RM2 pad order
    Steve was glancing back and forth to beat the 20 s timer. Each line now stays high
    until a key is pressed (label reprinted every 5 s), and lines go in pad order
    3 (CLK), 5 (DATA), 9 (CS), 12+13 (WL_ON).
    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
2026-11-07 Add radio_stress: one cold RM2 bring-up per boot, tally across watchdog reboots
    Rebuilt from the radio_stress .uf2 used on board #1 (2026-11-01), whose source was
    never pushed. Same output; defaults to full gSPI speed only (the slow speeds always
    failed and are behind -DRADIO_STRESS_SLOW=ON), and a hung bring-up now counts as a
    FAIL via an 8 s watchdog.
    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
    [main.cpp]
2026-11-08 Add cable_test: IDC ribbon loopback tester with speed sweep, crosstalk and soak
    Plug a ribbon between any two of J5-J8: DC wiring check (shorts, opens,
    crossed lines), then a PIO eye sweep at 4.5 Mbit/s per line in both
    directions with crosstalk patterns, per-line PASS/WEAK/FAIL, and a soak
    with live error counts until the cable is pulled.
    Claude-Session: https://claude.ai/code/session_01NSi48dVDtzoezXUPui9X1L
    [main.cpp]
2026-11-08 cable_test: show what the wiring check sees on every pin while waiting
    Prints one character per data line on J5-J8 with each waiting reminder,
    and on 'd': '.' nothing, L/H stuck low/high, or the J number of the
    shroud whose pin follows it. For working out why a cable isn't seen.
    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
    [main.cpp]
2026-11-08 cable_test: skip each run's first word, show the board's own delay
    The pins start every run at 0, so patterns that start high read wrong for
    the first bit or two at early sample points; that showed up as 20 ns of
    crosstalk on every line of a good cable. Also print the fastest line's
    settle time as the floor to compare against.
    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
    [main.cpp]
2026-11-08 cable_test: fix hot-plugged cables not being detected
    The waiting loop skipped its reminder and key handling whenever the first
    wiring check saw something and the second didn't, so it could spin
    silently. Reminders and 'd' now run on every pass. The pull-down read is
    gone (RP2350-E9 can leave a pulled-down pin floating near 2 V); a short
    to power is now a pin that won't go low when driven.
    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
    [main.cpp]
